RuggedizedWrist/RuggedizedWrist.github.io/media/posters/contact-pitch-locked.jpg

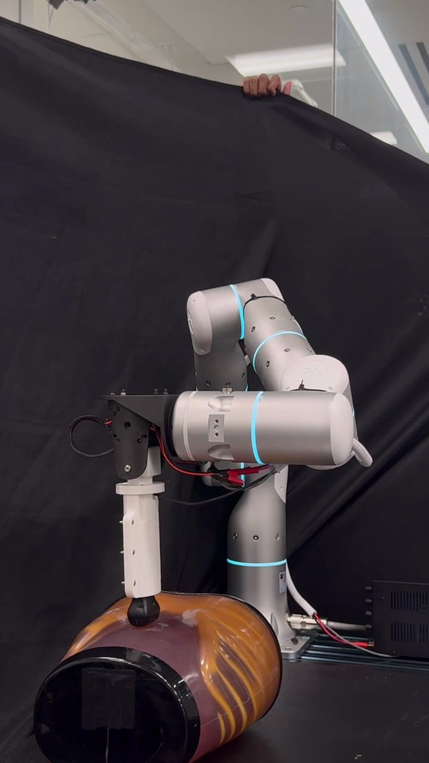
media/posters/contact-pitch-locked.jpg
