RuggedizedWrist/RuggedizedWrist.github.io/media/results/posters/cross-waist-9dof.jpg

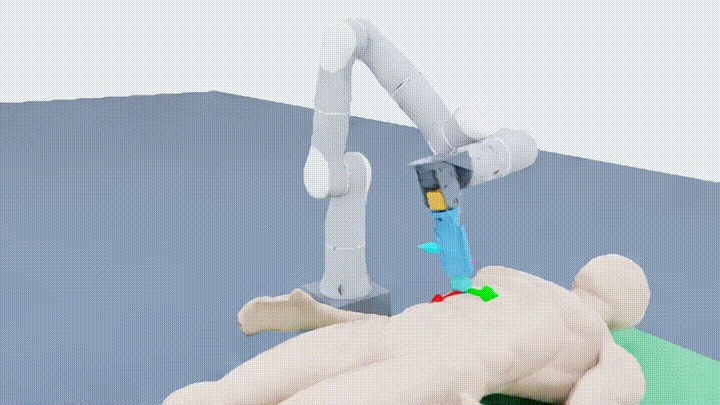
media/results/posters/cross-waist-9dof.jpg
