RuggedizedWrist/RuggedizedWrist.github.io/README.md

# DistalShift

Project page for **DistalShift: How Distal Redundancy Shapes Robot Arm Motion and Joint Loading**.

GitHub Pages serves this repository from `main` at [ruggedizedwrist.github.io](https://ruggedizedwrist.github.io/). The project is called DistalShift on the page. The organization and repository names stay RuggedizedWrist.

The anonymous review artifact is a separate repository and is not updated from here.
