RuggedizedWrist/RuggedizedWrist.github.io/docs/evidence/CLAIM_EVIDENCE_MATRIX.md

# Claim–evidence matrix

| Claim | Status | Evidence | Limitation |
|---|---|---|---|
| Higher sampled low-motion CARE coverage | supported within sampled criteria | [source](../generated/j9_corrected_all_tasks_20260907_0808/care/horizontal_v2/care_benchmark_summary.json) | method-specific arrival; geometric proxy; no global optimality |
| 97.76-97.98 percent lower proximal dynamic torque | supported in six formal free-space runs | [source](../generated/paper_s1_s2_s3_20260907/EXPERIMENT_AUDIT.json) | one pose and one deterministic trial per condition/speed; active distal allocation |
| Lower gravity-inclusive total motor torque | NOT supported by formal S3; increases 11.33-11.71 percent | [source](../generated/paper_s1_s2_s3_20260907/S23_matched_start/S3_summary/S3_metrics.csv) | total and dynamic definitions must remain separate |
| Contact torque-mechanism decomposition validated | NOT supported; diagnostic only | [source](../generated/paper_s1_s2_s3_20260907/S2_contact_15N/analysis/analysis_summary.json) | force-balance residual 0.241278 Nm exceeds 0.02 Nm |
| All contact scans passed | NOT supported | [source](../generated/j9_corrected_all_tasks_20260907_0808/rerun_manifest.json) | Cardiac/soft attempts incomplete; orientation/force gates unmet in several complete cycles |
| Reduced electrical consumption or calibrated tissue response | NOT measured | [source](../docs/PAPER_S1_S2_S3_SUPPLEMENT_ZH.md) | mechanical work is not electricity; kh is not tissue Young modulus |
| Exact mesh swept volume or hardware safety validated | NOT established | [source](../docs/PAPER_METHODS_AND_EXPERIMENTS_J9_V6_ZH.md) | joint state is available; body-center AABB and sampled clearances are only proxies |
