RuggedizedWrist/RuggedizedWrist.github.io/media/paper/distalshift.pdf

## DistalShift: How Distal Redundancy Shapes Robot Arm Motion and Joint Loading

Tian-Ao Ren¹*, Tongyu Wang¹,2*, Shixuan Zhao¹

, Rohan Karunaratne¹

, Tao Zhang¹
, Rachel
Thomasson¹

and Mark Cutkosky¹

Abstract— Seven-degree-of-freedom manipulators provide redundancy for six-dimensional tool-pose control, yet local tool reorientation can still require substantial proximal-arm motion. We present a compact two-degree-of-freedom distal wrist that localizes tool reorientation near the endpoint. The Contact-Anchored Reorientation Envelope evaluates orientation coverage under a proximal-motion budget and supports comparisons of mounting and arrival strategies. Hardware experiments compare wrist-held and wrist-actuated configurations for ultrasound probe manipulation across five free-space and phantom-contact conditions, retaining the same installed hardware. Wrist activation reduced mean reconstructed incremental proximal swept volume by 44.5–95.8% and baseline-subtracted torque excursion by 18.9–89.4%. During axial probe rotation in phantom contact, peak and RMS measured arm-joint torque decreased by 48.4% and 29.8%, respectively. These gains were task dependent and accompanied by increased orientation-tracking error. Complementary diagnostic simulations indicate lower whole-system absolute joint mechanical work than direct probe mounting, including the wrist joints’ contribution, despite higher proximal torque RMS. Together, these findings characterize how distal participation localizes tool motion and provides task-dependent mechanical benefits.

I. INTRODUCTION
Seven-degree-of-freedom (DoF) manipulators provide redundancy for controlling six-dimensional tool poses, but endpoint capability alone does not characterize the motion required from the rest of the robot [1]. After a tool reaches its target, a local orientation adjustment can still require substantial shoulder, elbow, and forearm reconfiguration. Small tool reorientations producing large swept arm motions pose an acute risk for robots operating in medical environments, where robots perform tasks beside a patient, operator, or surrounding equipment. For such robots, an important design question is not only whether the tool can reach a pose, but how much proximal motion is needed to realize it. Placing additional articulation near the tool offers a way to increase efficiency of motion. Macro–mini manipulation established the advantage of pairing a small distal mechanism

This work has been submitted to the IEEE for possible publication. Copyright may be transferred without notice, after which this version may no longer be accessible.
1Tian-Ao Ren, Tongyu Wang, Shixuan Zhao, Rohan Karunaratne, Tao Zhang, Rachel Thomasson and Mark Cutkosky are with the De-

Tongyu Wang is with the Department of Modern Mechanics, University of Science and Technology of China, Hefei, China. tongyuw@mail.ustc.edu.cn

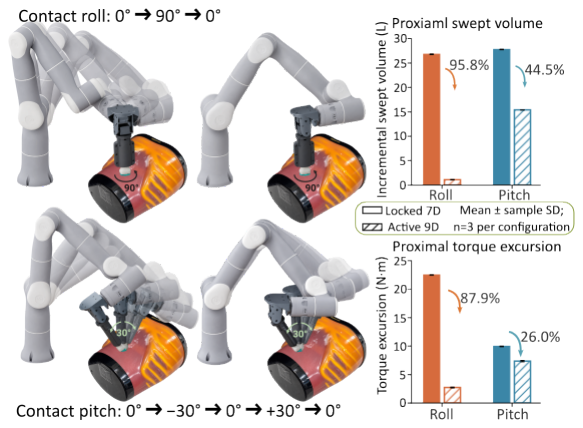
[picture p3: figure]

Fig. 1. Contact probe reorientation with a locked (7-DoF) or active (9-DoF) distal wrist. Left: simulation illustrations. Right: incremental proximal swept volume reconstructed from hardware trajectories and baseline-subtracted torque excursion (mean ± sample SD, n = 3 per condition).

with a larger positioning arm, including benefits in effective inertia and dynamic performance [2], [3]. A review of prosthetic and robotic wrists identifies compact packaging, low distal mass, and useful orientation range as recurring design considerations [4]. Recent work on compact independentwrist architectures also emphasizes a complementary tradeoff: serial wrists offer direct output joints and relatively simple kinematics, whereas parallel wrists can reduce moving mass at the cost of more involved kinematics and singularity analysis [5]. This distinction motivates treating wrist architecture and joint placement as design variables rather than counting added DoF alone. Prior work investigating the benefit of single-axis and 2-axis wrists for efficient operation in constrained spaces [6], [7] motivate studying not only the number of added joints, but their placement and use. Building on this foundation, we examine how equipping a commercial arm with a 2-DoF wrist changes both the spatial motion and measured joint loading during tool reorientation. Robot-assisted ultrasound provides a representative setting for this question. Once the probe reaches an acoustic window, it must be tilted and rotated to refine a view or change imaging planes while maintaining acoustic contact. Measurements of sonographer motion have informed end-effector designs for local probe adjustment [8]. Larger orientation changes also occur: the transthoracic echocardiography guideline describes a 90◦
transducer rotation from the parasternal longaxis view to obtain a parasternal short axis view [9]. These maneuvers motivate evaluating small local tilts and larger axial rotations near a nominal contact location, rather than treating probe positioning as a sequence of unconstrained

Hardware designs and software are available at https://ruggedizedwrist.github.io/.

[tianao, tongyuu]@stanford.edu

reaches.
Robotic ultrasound systems have been developed for diagnostic and interventional tasks across multiple clinical settings [10]. Recent work has addressed complementary aspects of this interaction, including standardized acquisition with dual-probe systems [11], automatic surface-normal alignment [12], and end-effectors that provide adjustable constant contact forces [13]. Operational-space and hybrid position–force control offer established foundations for specifying tool-motion and contact objectives [14], [15]. Our focus is the whole arm cost of realizing those objectives: the proximal configuration changes, additional occupied space, and joint loads associated with a prescribed probe motion. Evaluating these quantities alongside pose and force tracking connects endpoint performance to the robot’s behavior in its surrounding workspace.
A smaller proximal motion envelope does not by itself establish lower measured arm loading. The arm still supports the installed wrist and tool, while configuration and contactload transmission change during reorientation. We therefore examine when distal participation provides concurrent spatial and load benefits, and how these benefits relate to achieved task tracking.
We present DISTALSHIFT, an open-source 2-DoF wrist that provides local tilt and axial rotation between a commercial 7-DoF arm and its tool. A kinematic coordination layer combines wrist reorientation with the arm’s Cartesian motion–force controller and compensates for tool translation induced by wrist motion. Hardware trials compare wrist-held and wrist-actuated operation within the same installed assembly, evaluating proximal spatial sweep, measured joint loading, and achieved task tracking. The Contact-Anchored Reorientation Envelope (CARE) and configuration-envelope analyses complement these trials by characterizing mounting and arrival choices under a proximal-motion budget. A supplementary diagnostic simulation comparison adds direct probe mounting and evaluates whole-system absolute joint mechanical work across direct-probe, wrist-held, and wrist-actuated configurations, including the contribution of the distal joints.
Across five hardware task conditions, wrist activation reduced mean reconstructed incremental proximal swept volume by 44.5–95.8% and baseline-subtracted torque excursion by 18.9–89.4%. Contact roll additionally reduced peak measured proximal-joint torque by 48.4% and raw joint-andtime torque RMS by 29.8%. These results identify substantial spatial benefits and task-dependent load reductions, together with their tracking tradeoffs. Figure 1 highlights the contact-roll and contact-pitch comparisons.
The contributions are:
- An open-source 2-DoF distal wrist and an arm–wrist coordination architecture compatible with a commercial Cartesian motion–force controller.
- A contact-anchored kinematic evaluation of reorientation coverage under bounded proximal motion, including arrival-strategy and mounting comparisons.
- A hardware characterization of task-resolved proximal

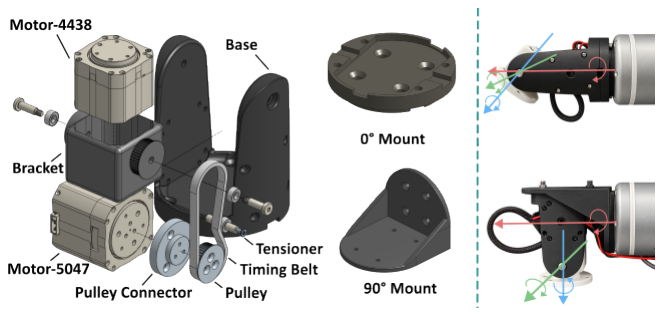
[picture p4: figure]

Fig. 2. 2-DoF distal wrist and mounting configurations. Left: exploded assembly with actuators and timing-belt transmission. Center: 0

- and 90◦
mounting adapters. Right: corresponding assembled configurations.

spatial sweep, measured joint loading, and tracking under five conditions, complemented by a diagnostic comparison of direct-mount simulation of absolute joint mechanical work of the whole-system.
Although ultrasound motivates the evaluation, the formulation concerns tool reorientation near a fixed point or contact region and can guide similar studies in inspection and surface-interaction tasks.

II. SYSTEM AND CONTROL ARCHITECTURE

A. Open-Source 2-DoF Distal Wrist

The add-on wrist introduces two actuated rotational joints between the robot flange and tool without modifying the proximal manipulator. J8 provides local tilt, and J9 provides axial rotation aligned with the ultrasound probe’s acoustic axis. This distal arrangement places orientation motion near the tool [4], [16], while the arm supplies the remaining motion.
The mechanism comprises a mounting base, a pitch stage carrying the axial-rotation assembly, and a probe adapter (Fig. 2). J8 and J9 use HighTorque HTDW-5047-36-NE and HTDW-4438-32-NE planetary actuators with 36:1 and 32:1 gear ratios, respectively, and integrated encoders. The base and mounts are printed in Markforged Onyx; the bracket, pulley, and pulley connector use Formlabs Rigid 4000 Resin. The CAD assembly and URDF specify the mechanical layout and joint transforms.
The module weighs 720 g excluding the probe, with usable ranges of ±90◦

at J8 and ±180◦
at J9. The shortened probe adapter gives a nominal flange-to-contact-point distance of 290.4 mm. Interchangeable 0

◦

and transverse 90◦ mounts
are provided; all hardware experiments used the 90◦ assembly. Local wrist joint control operated at 500 Hz, while coordinated host references and experiment logging ran at approximately 100 Hz.
B. Arm–Wrist Kinematics and Coordination

Let qa = [q1, . . . , q7]

T and qw = [q8, q9]

T denote arm and
wrist configurations. Frames W, F, C, and P denote the world, robot flange, configured fixed arm TCP, and probe frame at the nominal contact point, respectively. With ATB expressing frame B in frame A, the probe pose is

W TP (qa, qw) = W TF (qa)

F TP (qw). | (1)

The rotation Rw(qw) and translation rw(qw) of F TP (qw) follow the configured serial wrist geometry, including jointorigin and probe offsets. The commercial arm interface uses a fixed configured TCP, F TC , whereas wrist articulation changes the actual flange-to-probe transform. Scripted pitch θ and axial roll ϕ specify W RP,d = W RP,0Rx(θ)Rz(ϕ), where W RP,0 is the initial probe orientation.
A kinematic coordination layer couples wrist actuation with the Flexiv non-real-time Cartesian motion–force interface, following the operational-space and hybrid position– force framework [14], [15]. For active operation, a bounded iterative orientation allocator produces q

alloc
w . Filtering, velocity and acceleration limits, joint margins, and a trackinglead bound yield q

cmd
w ; successive commands determine wrist velocity references. The residual flange orientation and translation compensation are

W RF,d =

W RP,dRw(q

alloc
w )

T
, | (2)

W pF,d =

W pP,d −

W RF,mrw(q

meas
w | ), | (3)

where d and m indicate desired and measured quantities. Coordination therefore combines residual orientation assignment with offset compensation, using the allocated wrist configuration for orientation and measured wrist angles and flange orientation for translation. In locked operation, the wrist holds its starting angles with powered drives, and the flange target is W TF,d = W TP,d[

F TP (q

meas

w )]⁻¹
. Both conditions use the fixed-TCP command W TC,d = W TF,d

F TC .
In free space, the arm uses Cartesian impedance control and the wrist tracks position–velocity references. During contact, the arm regulates force along the z-axis of a worldfixed task frame aligned with the initial probe push direction n, while tangential translation and orientation remain motion controlled. The normal-position reference follows the measured probe position, allowing force regulation to adjust contact depth. Wrist tracking is supplemented by bounded rotational impedance assistance, gravity compensation, and contact-force feedforward. Orientation error and measured wrist angular velocity generate an impedance moment mapped to J8–J9 through the wrist Jacobian transpose. The host supervises contact engagement; continuous force regulation remains within the Flexiv controller and does not use the host force estimate as a replacement feedback signal.
C. Calibration and Measurement
Probe geometry uses tuned joint origins, axes, encoder offsets, and the probe-tip transform, with encoder zeros synchronized to the mechanical reference posture. The fixed Flexiv tool definition retains a nominal payload mass of 1.204 kg, distinct from the wrist-module mass. Host force observation subtracts an empirical unloaded-force model, affine in flange-frame gravity, and a session offset captured once before contact. The corrected force is rotated to the world frame and supplemented by a bounded nominal-payloadmass times acceleration term to obtain fˆ︁W ; acceleration is estimated from fixed-payload center-of-mass velocity and filtered. Positive compression is fc = −n

Tfˆ︁W . Forceerror evaluation uses this estimate before the final scalar low-pass filter applied for contact supervision. The session offset remains fixed during contact; configurations outside the calibration domain use model extrapolation. Arm torque comes from the robot’s joint-torque channels. Probe pose and force metrics use kinematic reconstruction and processed flange sensing rather than independent external metrology.

III. TASK-DRIVEN KINEMATIC AND DYNAMIC ANALYSIS

A. Compared Simulation Strategies

The supplementary contact simulations compare direct-probe, wrist-held, and wrist-actuated configurations under shared probe-level references, timing, and contact conditions. Each configuration retains its respective mounting geometry and modeled distal mass. Whole-system absolute joint mechanical work is evaluated in Section III-F.
The offline kinematic study compares four allocation strategies: locked 7-DoF arm-only IK; generic 9-DoF IK with near-equal joint costs; distal-weighted 9-DoF IK that penalizes J1–J7 more than J8–J9; and a reorientation-aware method that selects the contact-arrival posture before using distal-weighted IK. The weighting is a null-space design choice, not a second controller or an equal-cost assumption [17].
The distal-weighted strategy uses
WD = diag(25I7, I2). | (4)

Here, I7 and I2 correspond to the proximal arm and distal wrist. The 25:1 ratio favors J8 and J9 while allowing J1–J7 to move when required by pose feasibility, joint limits, or clearance.

B. Reorientation-aware arrival selection

At each contact, equal-weight nine-joint IK solves the same zero-tilt, zero-axial-rotation probe pose from seven deterministic seeds: the configured Home and six singlejoint perturbations (J1: ±0.28 rad; J3: ±0.30 rad; J7: ±0.45 rad). Converged solutions are deduplicated at a nine-joint Euclidean distance below 10⁻³
rad. Each candidate
independently initializes distal-weighted IK for 15 coarse targets formed by tilt {−25, 0, 25}

◦
and axial rotation
{−90, −45, 0, 45, 90}

◦
, a subset of the full grid. Coarse success requires pose convergence within 2 mm and 2

◦
| , at
most 8

◦
J1–J7 RMS displacement from the candidate, and nonnegative target clearance. Candidates are ranked lexicographically by higher coarse success fraction, greater arrival clearance, and lower mean proximal RMS displacement over successful coarse targets; exact ties retain the first candidate. Arrival clearance is a ranking criterion, not a hard candidate filter. If all seven seeds fail, a Home-seeded fallback records arrival failure, and all full-grid targets remain infeasible. The selected arrival independently initializes all 143 targets using the unchanged target-level IK of the distal-weighted baseline, without inter-target warm starts or full-grid-based reselection.

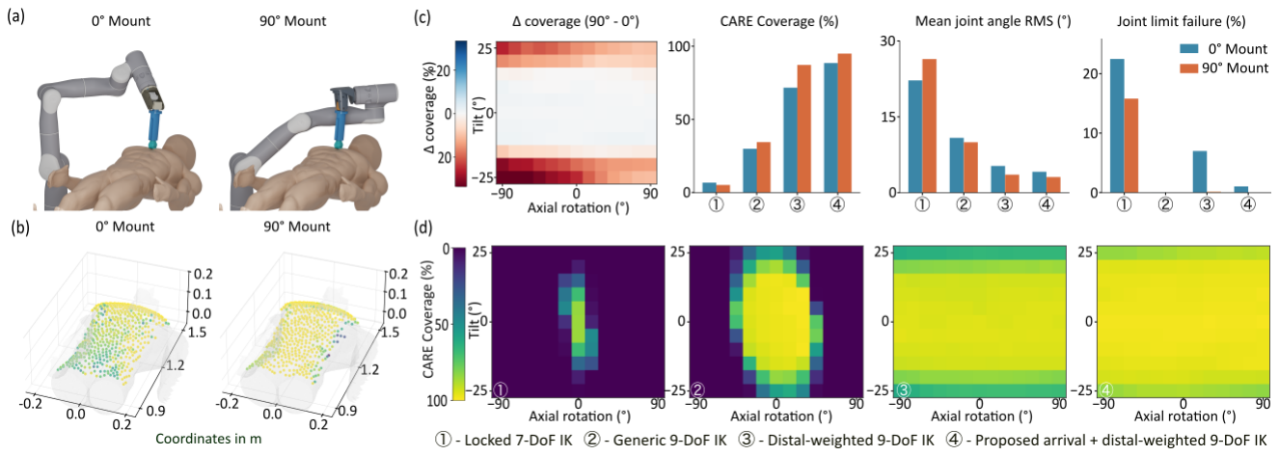
[picture p5: figure]

Fig. 3. CARE comparison of the original 0 ◦ and transverse 90◦ mounts. (a) Matched Isaac Sim renderings. (b) The 525 sampled torso contacts colored by proposed-method coverage over 143 tilt–axial- rotation targets. (c) Proposed-method coverage difference (90◦ − 0

◦), aggregate coverage, mean proximal J1–J7 RMS displacement, and joint-limit failure rate for the four methods. (d) Orientation-resolved coverage for the 90◦ mount. Heatmaps use a common 0–100% scale; positive difference means higher 90◦ coverage. Archived Home seeds and hardware revisions differ, so this is a complete-assembly comparison, not an isolated causal mount-angle ablation.

C. Clinically Motivated Reorientation Tasks
1) Local Ultrasound View Adjustment: The local-view task keeps the probe at the nominal parasternal contact region while commanding 0
- → +5◦ → −5
- → 0

◦
tilt at constant
normal force in clinical [10], [8]. The ±5
- motion represents
fine view correction; optional ±15◦

and ±30◦
trials stress the
extended range of a robotic ultrasound end effector. Both systems receive identical references.
2) Imaging-Plane Switching: The imaging-plane task rotates the probe about its acoustic axis as 0
- → 90◦ →
0

◦
at the same contact point and normal-force command. This PLAX-to-PSAX-style transition follows the guideline description of an approximately 90◦
clockwise rotation while
maintaining the parasternal window [9]; the return tests reversibility.
D. Reorientation Coverage Under a Proximal-Motion Budget (CARE)

The Contact-Anchored Reorientation Envelope (CARE) is the sampled set of probe orientations feasible at a fixed torso contact point under pose tolerances, joint limits, a geometric-clearance condition, and a J1–J7 motion budget. It is an offline capability-style kinematic benchmark [18], [19]; it does not measure force tracking, dynamic torque, tissue deformation, or continuous trajectory feasibility.
We sample Nc = 525 torso contact locations from the original patient mesh. At contact i, the neutral orientation is Ri,0, the acoustic-face center is pi
, and the target for local tilt αg and axial rotation βg is

R

d

i,g = Ri,0Ry(αg)Rz(βg), pd
i,g = pi
. | (5)

Here, Ry(αg) applies local tilt and Rz(βg) axial rotation about the tilted probe axis; p

d
i,g = pi keeps the acoustic-face center at the original contact point. Tilt angles span −25◦

to +25◦
in 5

◦
increments and
axial angles span −90◦

to +90◦

in 15◦
increments, giving
Ng = 143 targets per contact. The damped weighted IK solver uses coefficient 0.008, at most 90 iterations, maximum joint increment 0.20 rad, and a 1

◦
joint-limit margin.
For a fixed method m, contact i, and target g, let ∆qa,j denote the change of proximal joint j between the neutral arrival configuration and the target IK solution.The RMS proximal joint displacement is

da =

180
π

⌜⃓⃓⎷
1
7

∑︂

7

j=1

(∆qa,j )

2 [deg]. | (6)

This is the post-arrival RMS change of J1–J7 in degrees. J8 and J9 remain in the IK and joint-limit checks but are excluded from da, which measures only proximal-arm motion.
Let PF⁽m)
i,g denote the pose-feasibility indicator. It equals one only when the IK solution satisfies the translational tolerance of 2 mm, the rotational tolerance of 2

◦
, and the 1

◦
joint-limit margin; otherwise, it equals zero. For a proximal-motion budget B, the CARE success indicator is

I

(m)

i,g (B) = PF⁽m)
i,g 1{da ≤ B}1{cproxy ≥ 0}. (7)

Here, 1{·} is an indicator. The terms enforce pose feasibility, the J1–J7 RMS budget B, and nonnegative sampled clearance cproxy. The proxy compares link-centerline envelopes with the torso height field and bed bounding box; it rejects sampled penetration but is not continuous mesh collision checking or a hardware-safety certificate.
CARE coverage is calculated over all sampled contacts and orientation targets, including failed targets in the denominator:

CARE⁽m)

(B) = 1
NcNg

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
i,g (B). (8)

Thus, CARE⁽m)
(B) is the fraction of all 525 × 143 = 75,075 targets satisfying pose feasibility, the proximal-motion budget, and sampled clearance. The primary analysis

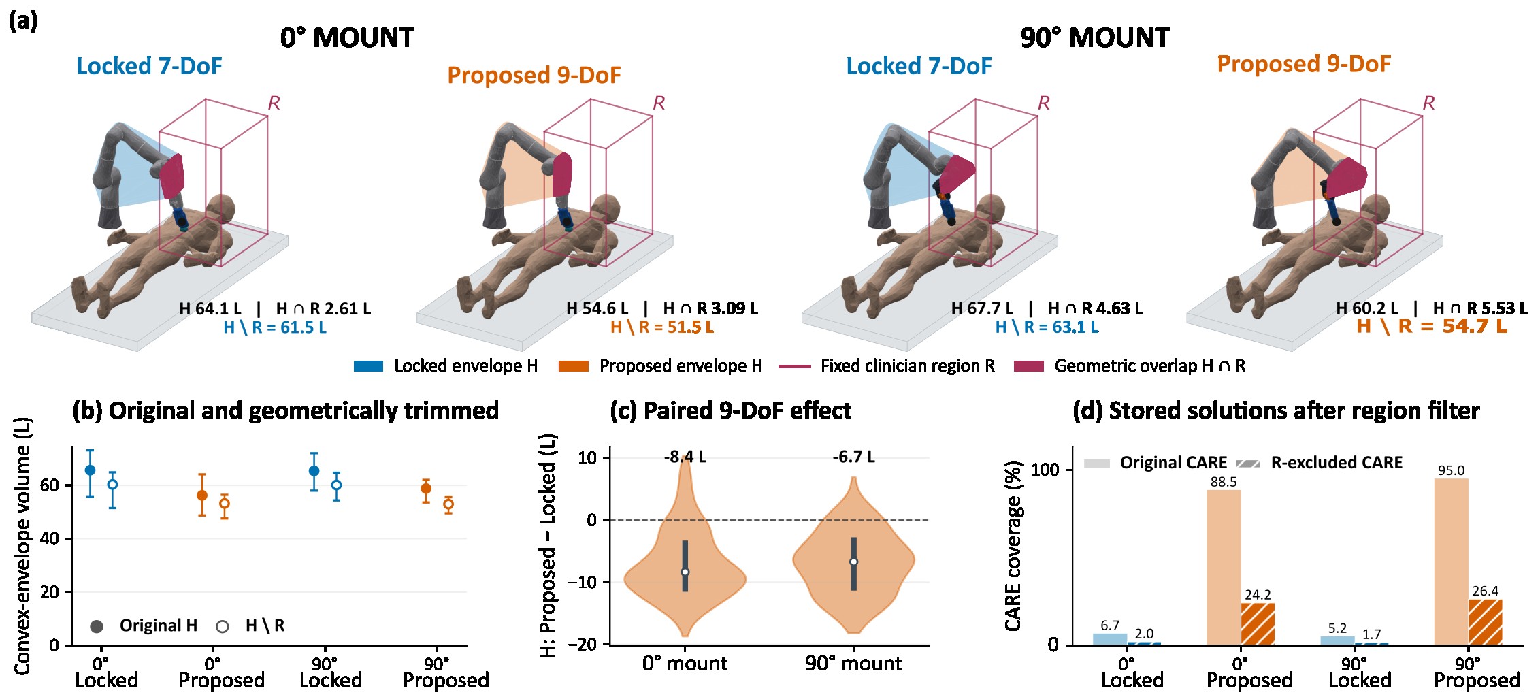
[picture p6: figure]

Fig. 4. CARE-based configuration envelopes and clinician-side screening for the 0

- and 90◦ assemblies. (a) Proximal hulls H at a common representative contact, fixed nominal region R, and their geometric intersections. (b) H and H \ R volumes; the latter is geometric trimming, not replanned motion. (c) Paired proposed-minus-locked hull-volume differences (median/IQR over 407 contacts with four-way shared targets). (d) Original and stored-target regionscreened coverage, each using all 75,075 targets per condition. Envelopes include method-specific neutral arrivals; the main coverage screen evaluates stored target configurations.

uses B = 8◦
and compares locked 7-DoF, generic 9-DoF, distal-weighted 9-DoF, and reorientation-aware arrival strategies.
Because methods may use different neutral arrival postures, CARE compares complete system-and-arrival policies rather than a matched-start causal ablation.
Mounting and allocation results: For the 0

◦
assembly,
CARE coverage was 6.74%, 29.90%, 71.67%, and 88.50% for arm-only, generic 9-DoF, distal-weighted, and proposed arrival-aware strategies, respectively. For the 90◦ assembly,
the corresponding values were 5.15%, 34.45%, 87.21%, and 94.96%. The intermediate nine-DoF comparisons show that coverage under the prescribed proximal-motion budget depends on allocation and arrival selection, rather than joint count alone. Within the evaluated mounting-and-arrival configurations, proposed-method coverage was 6.46 percentage points higher for the 90◦
assembly, providing a coverageoriented mounting rationale.
E. Kinematic Envelopes and Clinician-Side Workspace For each contact, we retain orientation targets successful in all four mounting–strategy conditions (0

◦

/90◦
and
locked/proposed). The hull H contains the transformed J1– J7 collision-mesh vertices at these stored solutions and each condition’s neutral arrival. This is a sampled configuration envelope, without trajectory interpolation. The numerical model retains the CARE pipeline’s J7 placement correction. Statistics include all 407 contacts with nonempty four-way intersections; empty sets are excluded rather than assigned zero volume. The representative contact in Fig. 4(a) is the centroid-nearest contact among those with at least five shared targets.
The fixed nominal clinician-side region is a box centered at (0.80, 0.06, 0.50) m with dimensions 0.50×0.60×0.90 m, aligned with the common robot-base frame. Positive y points

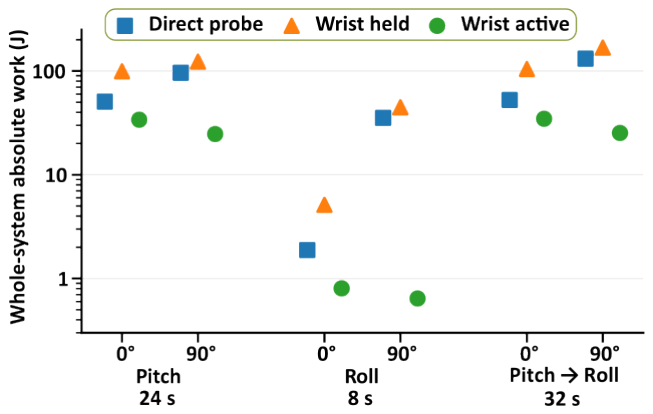
[picture p7: figure]

Fig. 5. Whole-system absolute joint mechanical work in 15 N contact simulations: pitch (0

| ◦ →+30◦ →−30◦ →0 ◦, 24 s), roll (0 ◦ →90◦, 8 s),
and their continuous sequence (32 s). The 0
| ◦ and 90◦ groups retain distinct
direct-probe baselines. Bars represent single runs; active totals include J8– J9. Results remain diagnostic: dynamics checks are unmet, with additional tracking violations in pitch and combined runs.

headward and positive x toward the clinician side. All methods and mountings use this same headward, robotnear layout. We report the geometric overlap H ∩ R and remainder H \ R. Separately, the stored-target screen rejects original CARE successes whose proximal mesh vertices enter R, without re-solving IK. Its denominator remains all 75,075 sampled targets; neutral-arrival intersections are logged separately and do not enter the main screen. This is a vertex-based layout screen rather than continuous collision checking.
On shared targets, the proposed strategy reduced hull volume relative to the locked baseline by a median paired 8.36 L (12.7%) at 0
| ◦

and 6.71 L (10.3%) at 90◦
. Under
the revised region screen, proposed coverage was 24.17% and 26.36%, compared with 2.03% and 1.65% for the corresponding locked baselines. Thus the proposed strategy combines smaller shared-target proximal envelopes with a larger set of accepted stored targets. The proposed 90◦ assembly retained 2.19 percentage points more coverage than its 0
| ◦
counterpart, although its paired hull volume was 1.38 L larger at the median. Mounting selection therefore

TABLE I

SPATIAL AND MEASURED-LOAD STATISTICS (MEAN ± SAMPLE SD, n = 3 PER ROW). V∆ IS RECONSTRUCTED OVER THE EXECUTED INTERVAL; Pτ ,

Rτ , AND Eτ USE MOTION SAMPLES ONLY.

Task | Wrist | V∆ (L) | Pτ (N m) | Rτ (N m) | Eτ (N m)
Free axial | Locked | 27.28 ± 0.03 | 53.10 ± 0.07 | 18.932 ± 0.005 | 23.226 ± 0.027
| Active | 1.25 ± 0.01 | 30.24 ± 0.08 | 14.322 ± 0.015 | 2.454 ± 0.052
Free square | Locked | 70.84 ± 0.04 | 65.89 ± 0.10 | 19.426 ± 0.009 | 21.816 ± 0.080
| Active | 30.03 ± 0.09 | 56.22 ± 0.04 | 19.159 ± 0.022 | 11.691 ± 0.145
Contact roll | Locked | 26.80 ± 0.05 | 48.94 ± 0.99 | 16.362 ± 0.012 | 22.491 ± 0.044
| Active | 1.13 ± 0.01 | 25.27 ± 0.09 | 11.484 ± 0.007 | 2.729 ± 0.057
Contact pitch ±15◦ | Locked | 14.19 ± 0.02 | 57.63 ± 0.43 | 21.513 ± 0.007 | 5.490 ± 0.210
| Active | 7.85 ± 0.01 | 55.54 ± 0.19 | 21.490 ± 0.011 | 4.450 ± 0.024
Contact pitch ±30◦ | Locked | 27.78 ± 0.04 | 60.88 ± 0.66 | 21.651 ± 0.006 | 9.948 ± 0.039
| Active† | 15.41 ± 0.01 | 58.90 ± 0.31 | 21.781 ± 0.007 | 7.364 ± 0.108

balances reorientation coverage and spatial footprint rather than treating their benefits as interchangeable.

F. Whole-System Mechanical Work

To complement the same-assembly hardware comparison, we analyze 18 contact simulations spanning two mounting geometries and direct-probe, wrist-held, and wrist-actuated configurations, with shared nominal probe references and timing within each task. Modeled distal masses are 0.484 kg for direct mounting and 1.204 kg with the wrist. Whole-system absolute joint mechanical work is

Wabs =

∫︂

T

∑︂

j∈J

|τm,j (t) ˙qj (t)| dt, | (9)

using full gravity-inclusive simulated drive torque and actual joint velocity, without baseline subtraction. The sum includes J1–J7 for direct/held and J1–J9 for actuated operation. Across the six task–mount pairs, recorded Wabs was 33.1– 98.2% lower in actuated operation than with the corresponding direct mounts (Fig. 5). The 90◦
actuated assembly also
had lower absolute work than both evaluated direct mounts in every task. Proximal raw torque RMS was nevertheless 5.0–39.6% higher than the corresponding direct mounts. These diagnostic observations suggest reduced whole-system mechanical-work throughput, including the wrist’s contribution, rather than lower electrical consumption or uniformly lower joint loading.

IV. HARDWARE EXPERIMENTS AND RESULTS

Hardware experiments quantified proximal-arm spatial sweep and joint loading during scripted probe motion; pose tracking, processed force error, and execution pauses provide the associated task-fidelity context.

A. Experimental Protocol and Evaluation Metrics
a) Setup and comparisons: The setup comprised a Flexiv Rizon 4s arm, the 2-DoF wrist, a Butterfly iQ+ probe [20], and an ABDFAN ultrasound-training phantom [21]. The contact protocol follows prior force-regulated robotic-ultrasound end-effectors [13], [22]. Both configurations used the same 90◦
assembly, payload, scripted references, timing, and task-specific controllers (Section II-B). Initial states were nominally matched and recorded, with each trial’s initial arm configuration supplying the null-space reference. Locked J8–J9 used powered position holding with zero reference velocity. This same-assembly comparison evaluates the benefit of using the installed distal articulation together with its coordination policy. Arm translational stiffness was 3500 N/m per axis. Rotational stiffness and damping ratios were 675 N m/rad and 0.7 in free space, and 300 N m/rad and 0.8 in contact, where the normal direction was force controlled. Each of the five conditions in Table II comprised three trials per configuration (30 trials total). Conditions were analyzed separately, retaining records with tracking penalties or internal pauses.

TABLE II

SCRIPTED TASK CONDITIONS. EACH HAS THREE LOCKED AND THREE

ACTIVE TRIALS. DURATIONS ARE NOMINAL MOTION TIMES,

EXCLUDING APPROACH AND PRE-/POST-HOLDS.

Task | Probe reference | Time (s) Force (N)
F-axial | 0
- → 90◦ → 0
◦; 5 s hold at 90◦ | 16 | –
F-square | 100 mm square; midpoint pitch
±30◦; corner roll ±45◦
416 | –
C-roll | 0
- → 90◦ → 0
- | 32 | 15
C-pitch | 0
- → −α → 0
- → +α → 0

◦;
α = 15◦ or 30◦
32 | 15

F and C denote free-space and contact tasks. The two pitch amplitudes are distinct conditions. Active 30◦ contact pitch additionally incurred internal pauses, reported in the results.

b) Intervals and measured torque: The motion interval M contains samples labeled motion *; preparation, approach, settling, holds, and pauses are excluded. For scalar xk, timestamp-weighted RMS is

RM(x) = √︄∑︁
k∈M ∆tkx

2
∑︁

k
k∈M ∆tk
, | (10)

where ∆tk is the next timestamp difference and the last sample has zero weight. With τi
the measured proximal
torque and τ¯i,0 its mean during the nominal 5 s initial hold,

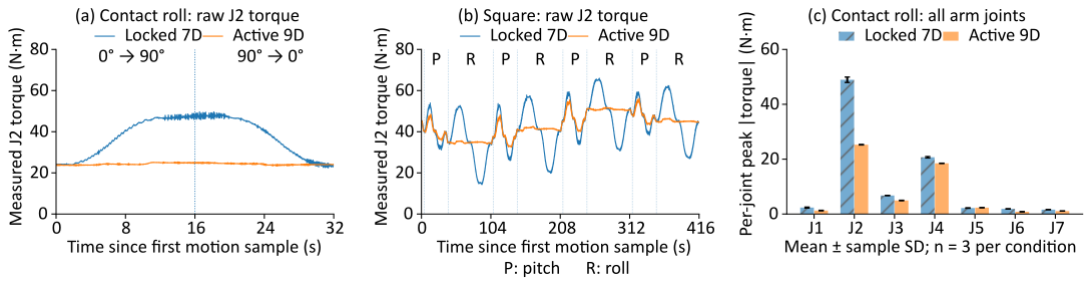
[picture p8: figure]

Fig. 6. Measured proximal torque. (a) Raw J2 contact-roll and (b) square traces for repeat 1 over the complete motion interval; no smoothing, warping, or fitted shifts. P/R mark pitch/roll and intervening segments are translations. (c) Per-joint contact-roll peak torque (mean ± sample SD, n = 3). J2 was the maximum-load joint and is not representative of all seven joints.

we report

Pτ = max
i=1,...,7
k∈M
|τi,k|, | (11)

Rτ =

⌜⃓⃓⎷
1
7

∑︂

7

i=1

RM(τi)

2, | (12)

Eτ =

∑︂

7

i=1

RM(τi − τ¯i,0). | (13)

Pτ and Rτ summarize peak and raw RMS loading. The overview’s complementary Eτ sums seven per-joint RMS values; it is not a resultant torque. Initial-hold subtraction does not remove changing gravity, contact, or friction loads, and none of these statistics is energy or an isolated inertial/velocity-product torque.
c) Reconstructed spatial sweep: Recorded J1–J7 trajectories drove the archived arm URDF and seven closed collision meshes. Let O(t) be their occupied-solid union and O0 the first-motion occupancy. Over the executed interval Te (holds and pauses retained), we compute

U = O0 ∪

⋃︂

t∈Te

O(t), | (14)
V∆ = vol(U \ O0). | (15)

V∆ excludes the initial region and counts overlaps and revisits once. The base, wrist, probe, cables, and phantom are excluded; this is a collision-model reconstruction, not direct volume metrology or a whole-system safety metric. All trials used a world-aligned 2.5 mm voxel grid and a 0.625 mm sampled-vertex displacement threshold with interval boundaries preserved. Halving that threshold changed ten representative repeat-1 results by at most 1.36%; the four axial cases checked at 1.25 mm changed by at most 0.90%. These are sensitivity checks, not geometric error bounds.
d) Aggregation and task fidelity: Each trial contributes one value. Figures and load statistics report mean ± sample SD, with reductions from condition means; SD is withinsetting scatter, not model uncertainty. CSV recomputation agreed with archived torque metrics. Table I summarizes spatial/load results; Table III retains motion-window pose/force RMSE and pauses internal to Te. Probe pose is arm–wrist FK and force is a processed flange-sensor estimate, not independent metrology.
B. Free-Space Reorientation and Composite Motion
a) Axial reorientation: The free-space axial task showed concurrent spatial and load benefits: wrist activation reduced incremental proximal swept volume by 95.4% and peak measured arm torque by 43.1%. Raw RMS torque also decreased, although active orientation-tracking error was larger.
b) Composite square task: Phase-resolved results show that reduced proximal motion was concentrated in reorientation. Summed J1–J7 travel was nearly unchanged during translation but decreased during pitch and especially roll, where it fell from 50.320 to 1.061 rad. The largest measured torque occurred during roll in locked operation and during pitch in active operation (Fig. 6(b)). Despite the smaller spatial sweep and torque excursion, motion-window raw RMS torque decreased by only 1.4%.
C. Phantom-Contact Reorientation

Contact tasks used a 15 N processed-compression setpoint, with contact depth governed by normal-force regulation during reorientation.
a) Axial contact reorientation: Contact roll combined a 95.8% reduction in incremental proximal swept volume with 48.4% lower peak measured arm torque and 29.8% lower raw joint-and-time torque RMS. J2 was the maximum-load joint (Fig. 6(a,c)). Processed normal-force RMSE was 0.176 N for locked and 0.126 N for active operation; active orientation and tangential tracking errors were larger (Table III).
b) Contact pitch at two amplitudes: Both pitch amplitudes retained spatial and torque-excursion benefits. Incremental swept volume decreased by approximately 45%, while excursion decreased by 18.9% at 15◦

and 26.0% at 30◦
Raw RMS torque was nearly unchanged at 15◦ and increased
by 0.60% at 30◦

. The active 30◦
trials included 2.43±0.03 s of internal pauses and had larger processed force error (Table III). Pauses were retained in spatial reconstruction but excluded from the primary motion-only torque statistics; excursion remained lower when pauses were included. These same-setting repetitions do not establish crossworkspace generalization, whole-system energy savings, or clinical imaging quality.

TABLE III

TASK-FIDELITY CONTEXT: MOTION-WINDOW MEANS OVER THREE

TRIALS. THESE ARE NOT PEAK ERRORS OR INDEPENDENTLY MEASURED

ABSOLUTE ACCURACIES; PAUSES ARE INTERNAL TO Te.

Task | Wrist | ep (mm) eR (

◦) ef (N) Pause (s)

F-axial | Locked | 0.635 | 1.469 | – | 0.00
| Active | 0.536 | 3.264 | – | 0.00
F-square | Locked | 0.542 | 0.341 | – | 0.00
| Active | 1.259 | 1.423 | – | 0.00
C-roll | Locked | 0.354 | 0.657 | 0.176 | 0.00
| Active | 0.611 | 1.614 | 0.126 | 0.00
C-pitch 15◦ Locked | 0.432 | 0.261 | 0.209 | 0.00
| Active | 1.108 | 0.729 | 0.206 | 0.00
C-pitch 30◦ Locked | 0.614 | 0.476 | 0.605 | 0.00
| Active† | 1.596 | 1.182 | 1.059 | 2.43

ep: FK position RMSE in free space or tangential RMSE in contact; eR: FK orientation RMSE; ef : processed normal-force RMSE. The † condition contains internal pauses. Force estimation can extrapolate outside its calibration domain; small internal RMSE is not independent force-accuracy validation.

V. DISCUSSION
The CARE comparisons show that distal redundancy should be considered together with motion allocation and arrival selection. The proposed strategy increased sampled coverage and reduced shared-target proximal configuration envelopes relative to locked operation in both assemblies. Higher coverage for the 90◦
assembly, but not a uniformly smaller envelope, motivates evaluating mounting by both task access and proximal space.
The hardware results distinguish spatial savings from measured-load reductions. Axial reorientation provided both, whereas contact pitch retained smaller swept volumes and torque excursions with little change in raw torque RMS. A lower Eτ indicates smaller departures from the initial holding torque, not necessarily a lower raw torque magnitude. The square task reinforces this distinction: proximal travel decreased mainly during reorientation, while aggregate motion-window raw RMS changed little.
The direct-mount diagnostics further show that lower whole-system absolute joint mechanical work can coexist with higher proximal torque RMS, even when the wrist’s own work is included.
Together, these findings motivate matching distal articulation and its coordination policy to the tool’s dominant reorientation demands, rather than evaluating added DoF alone. The hardware benefits were obtained through the existing commercial motion–force interface. Increased orientation errors and the pauses in the largest pitch condition identify coordinated tracking as a priority for refinement; application suitability should be assessed against task-specific pose, force, and timing requirements.

VI. CONCLUSIONS
We presented an open-source two-DoF distal wrist integrated with a commercial seven-DoF arm. CARE and configuration-envelope analyses inform mounting and arrival choices. Across five hardware conditions, wrist activation reduced incremental proximal swept volume by 44.5–95.8% and baseline-subtracted torque excursion by 18.9–89.4%, with additional raw-torque reductions in axial reorientation. Complementary diagnostic simulations indicate lower whole-system absolute joint mechanical work than direct probe mounting, including the wrist’s own contribution, despite higher proximal torque RMS. Together, these results support task-aware mounting and coordination for localizing tool motion and obtaining task-dependent load and mechanical-work benefits, assessed alongside achieved tracking performance.

ACKNOWLEDGMENT
Acknowledgements omitted for double-blind review.

REFERENCES

[1] B. Siciliano and O. Khatib, Springer Handbook of Robotics. Springer, 2016.
[2] O. Khatib, “Reduced effective inertia in macro-/mini-manipulator systems,” in The fifth international symposium on Robotics research, 1991, pp. 279–284.
[3] A. Bowling and O. Khatib, “Design of macro/mini manipulators for optimal dynamic performance,” in Proceedings of the IEEE International Conference on Robotics and Automation, vol. 1. IEEE, 1997, pp. 449–454.
[4] N. M. Bajaj, A. J. Spiers, and A. M. Dollar, “State of the art in artificial wrists: A review of prosthetic and robotic wrist design,” IEEE Transactions on Robotics, vol. 35, no. 1, pp. 261–277, 2019.
[5] C. Devmalya, B. Kim, and O. Khatib, “Maestro: High-performance, compact, singularity-free, and intrinsically safe robot arm,” in Proceedings of the International Symposium on Experimental Robotics (ISER), 2025.
[6] W. Ruotolo, R. Thomasson, J. Herrera, A. M. Gruebele, and M. R. Cutkosky, “Distal hyperextension is handy: High range of motion in cluttered environments,” IEEE Robotics and Automation Letters, vol. 5, no. 2, pp. 921–928, 2020.
[7] R. Thomasson, A. Bernardini, H. Li, C. Xing, A. Hajj-Ahmad, and
M. R. Cutkosky, “SLIM: A symmetric, low-inertia manipulator for constrained, contact-rich spaces,” IEEE Robotics and Automation Letters, vol. 10, no. 9, pp. 8682–8689, 2025.
[8] L. Lindenroth, R. J. Housden, S. Wang, J. Back, K. S. Rhode, and
H. Liu, “Design and integration of a parallel, soft robotic end-effector for extracorporeal ultrasound,” IEEE Transactions on Biomedical Engineering, vol. 67, no. 8, pp. 2215–2229, 2020.
[9] C. Mitchell, P. S. Rahko, L. A. Blauwet, B. Canaday, J. A. Finstuen,
M. C. Foster, K. Horton, K. O. Ogunyankin, R. A. Palma, and E. J. Velazquez, “Guidelines for performing a comprehensive transthoracic echocardiographic examination in adults: Recommendations from the american society of echocardiography,” Journal of the American Society of Echocardiography, vol. 32, no. 1, pp. 1–64, 2019.
[10] A. M. Priester, S. Natarajan, and M. O. Culjat, “Robotic ultrasound systems in medicine,” IEEE Transactions on Ultrasonics, Ferroelectrics, and Frequency Control, vol. 60, no. 3, pp. 507–523, 2013.
[11] J. Housden, S. Wang, X. Bao, J. Zheng, E. Skelton, J. Matthew, Y. Noh,
O. Eltiraifi, A. Singh, D. Singh, and K. Rhode, “Towards standardized acquisition with a dual-probe ultrasound robot for fetal imaging,” IEEE Robotics and Automation Letters, vol. 6, no. 2, pp. 1059–1065, 2021.
[12] X. Ma, W.-Y. Kuo, K. Yang, A. Rahaman, and H. K. Zhang, “A-SEE: Active-sensing end-effector enabled probe self-normal-positioning for robotic ultrasound imaging applications,” IEEE Robotics and Automation Letters, vol. 7, no. 4, pp. 12 475–12 482, 2022.
[13] X. Bao, S. Wang, R. J. Housden, J. V. Hajnal, and K. S. Rhode, “A constant-force end-effector with online force adjustment for robotic ultrasonography,” IEEE Robotics and Automation Letters, vol. 6, no. 2, pp. 2547–2554, 2021.
[14] O. Khatib, “A unified approach for motion and force control of robot manipulators: The operational space formulation,” IEEE Journal on Robotics and Automation, vol. 3, no. 1, pp. 43–53, 1987.
[15] M. H. Raibert and J. J. Craig, “Hybrid position/force control of manipulators,” Journal of Dynamic Systems, Measurement, and Control, vol. 103, no. 2, pp. 126–133, 1981.
[16] K. V. Gochev, V. Narayanan, B. J. Cohen, A. Safonova, and
M. Likhachev, “Motion planning for robotic manipulators with independent wrist joints,” in 2014 IEEE International Conference on Robotics and Automation (ICRA). IEEE, 2014, pp. 461–468.

[17] A. Dietrich, C. Ott, and A. Albu-Schaffer, “An overview of null space ¨ projections for redundant, torque-controlled robots,” The International Journal of Robotics Research, vol. 34, no. 11, pp. 1385–1400, 2015.
[18] F. Zacharias, C. Borst, and G. Hirzinger, “The capability map: A kinematic representation for multicontact planning,” The International Journal of Robotics Research, vol. 30, no. 12, pp. 1555–1576, 2011.
[19] V. Kumar, S. Sen, S. S. Roy, C. Har, and S. Shome, “Design optimization of serial link redundant manipulator: an approach using global performance metric,” Procedia Technology, vol. 14, pp. 43–50, 2014.
[20] Butterfly Network, “Butterfly iQ+ ultrasound system,” https://www.butterflynetwork.com/iq-plus, 2026, accessed: Sep. 2026.
[21] Kyoto Kagaku, “ABDFAN abdominal ultrasound examination phantom,” https://www.kyotokagaku.com, 2026, accessed: Sep. 2026.
[22] X. Bao, S. Wang, L. Zheng, R. J. Housden, J. V. Hajnal, and K. Rhode, “A novel ultrasound robot with force/torque measurement and control for safe and efficient scanning,” IEEE Transactions on Instrumentation and Measurement, vol. 72, pp. 1–12, 2023.
