RuggedizedWrist/RuggedizedWrist.github.io/media/cross-waist-7dof.gif

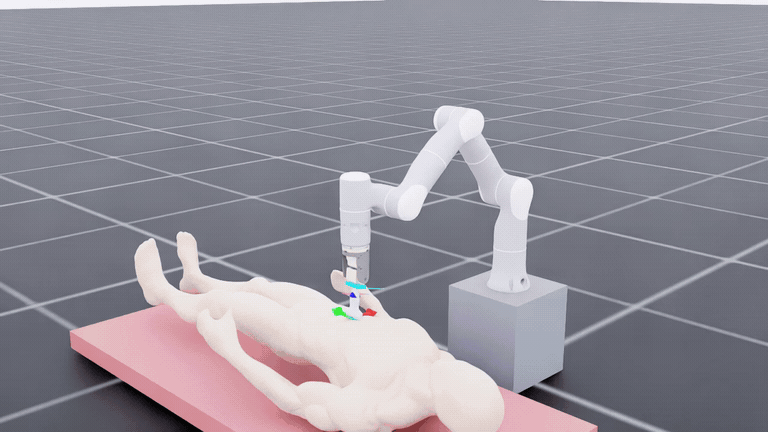
media/cross-waist-7dof.gif
