RuggedizedWrist/RuggedizedWrist.github.io/media/cross-waist-9dof.gif

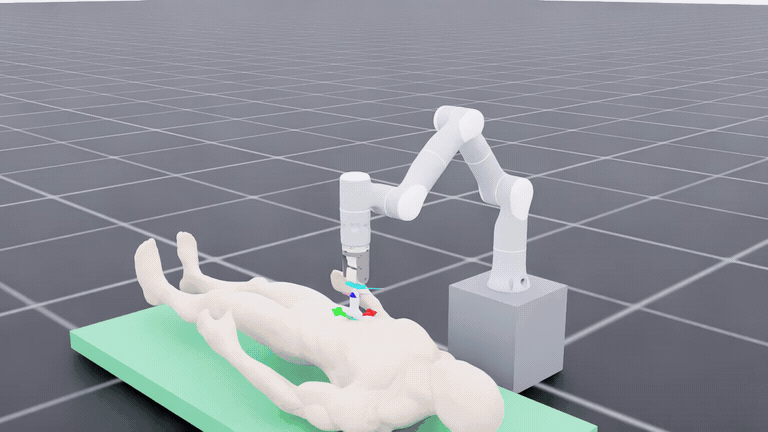
media/cross-waist-9dof.gif
