RuggedizedWrist/RuggedizedWrist.github.io/media/figures/contact-roll.png

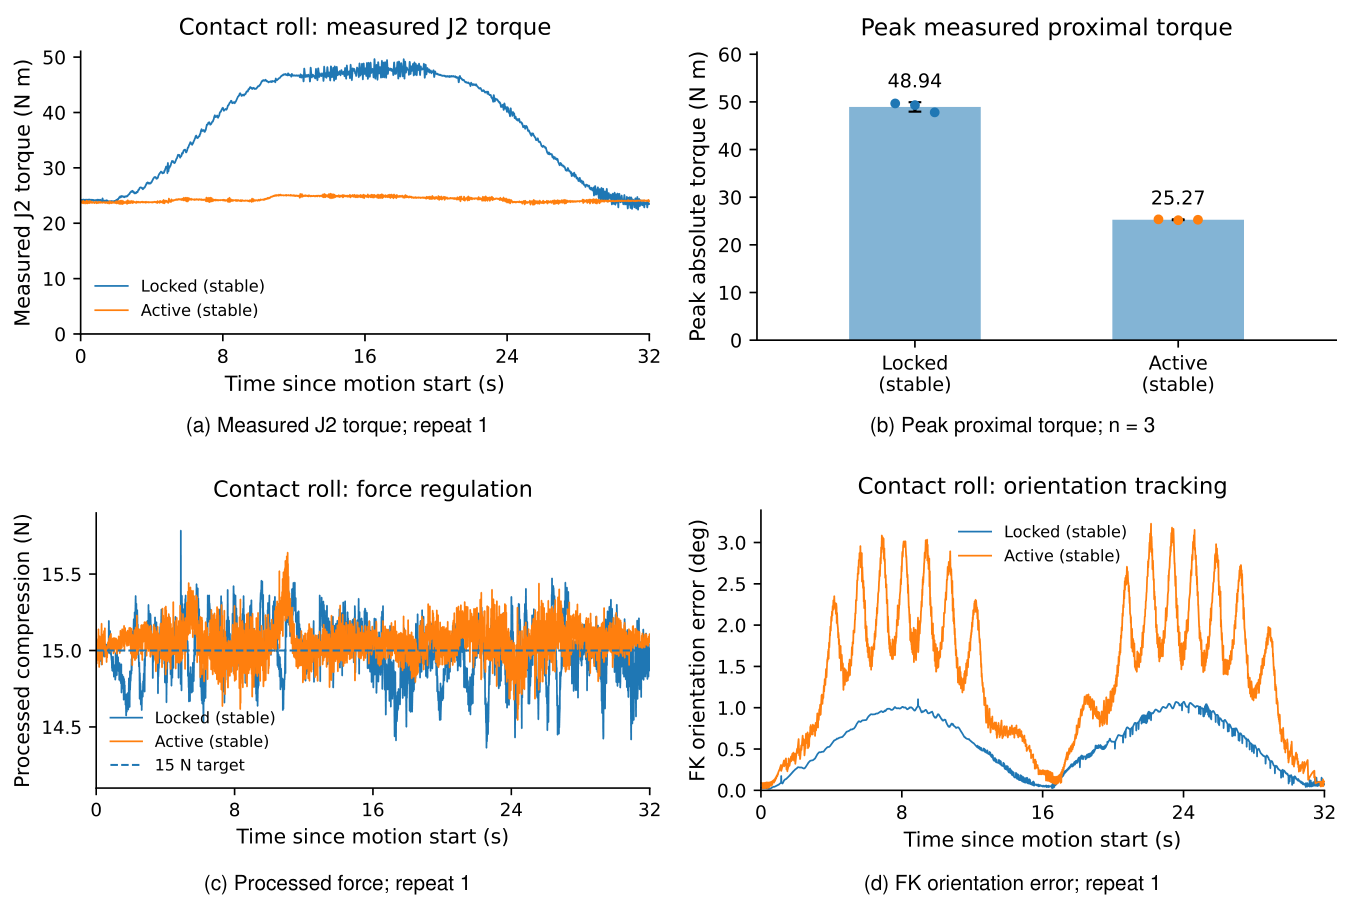
media/figures/contact-roll.png
