RuggedizedWrist/RuggedizedWrist.github.io/media/figures/motion-7dof-pitch.png

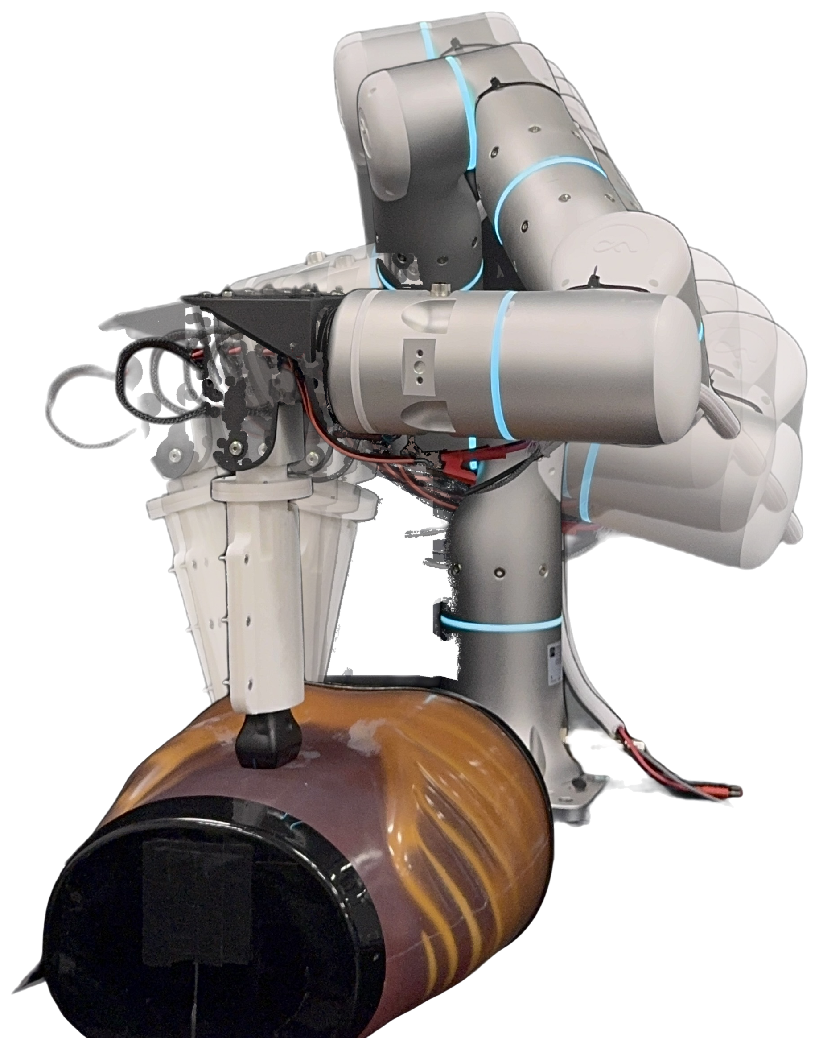
media/figures/motion-7dof-pitch.png
