RuggedizedWrist/RuggedizedWrist.github.io/media/figures/motion-7dof-roll.png

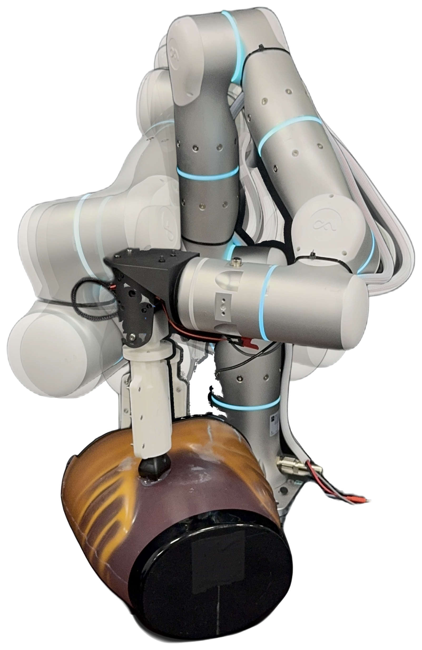
media/figures/motion-7dof-roll.png
