RuggedizedWrist/RuggedizedWrist.github.io/media/figures/motion-9dof-pitch.png

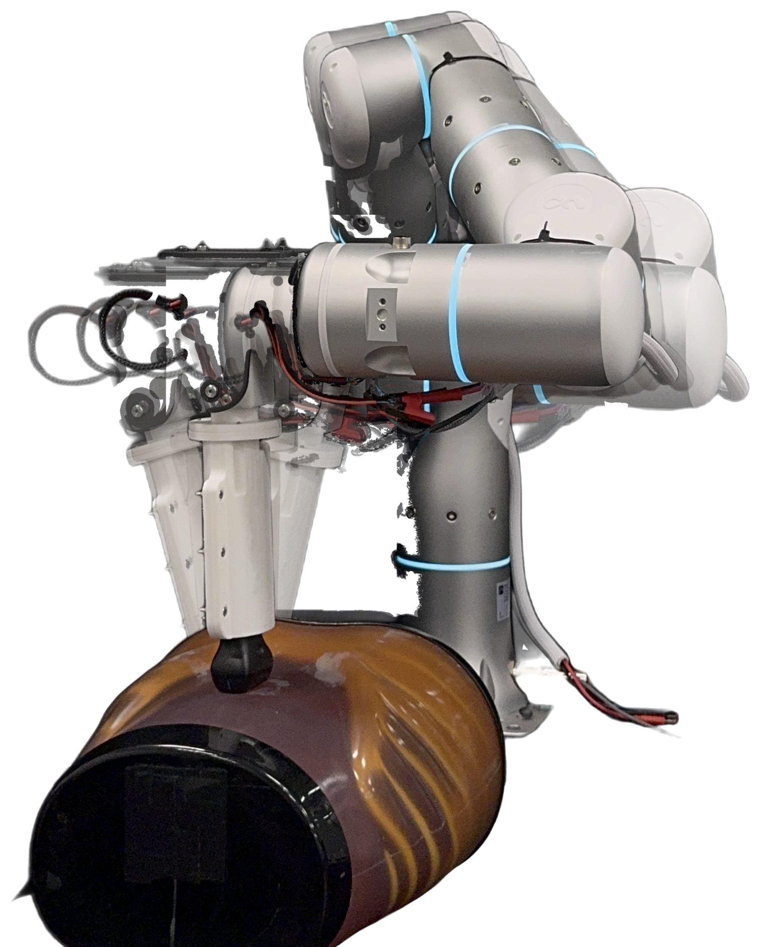
media/figures/motion-9dof-pitch.png
