RuggedizedWrist/RuggedizedWrist.github.io/media/figures/motion-9dof-roll.png

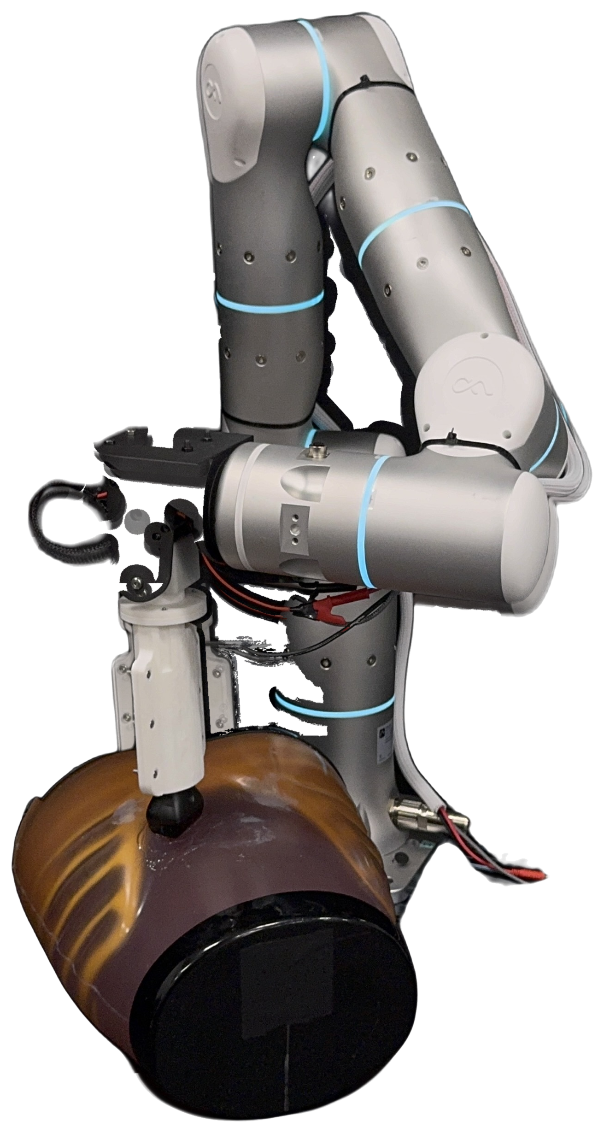
media/figures/motion-9dof-roll.png
