RuggedizedWrist/RuggedizedWrist.github.io/media/figures/overview.png

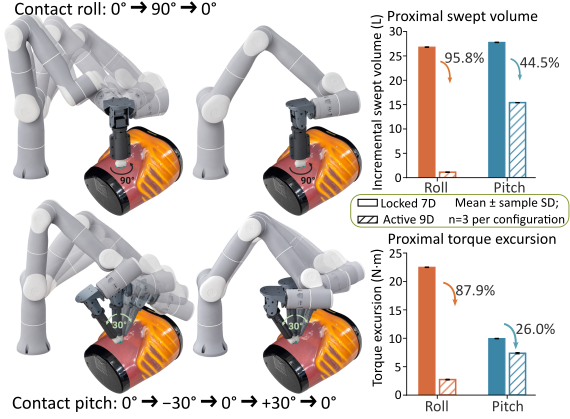
media/figures/overview.png
