RuggedizedWrist/RuggedizedWrist.github.io/media/heart-7dof.gif

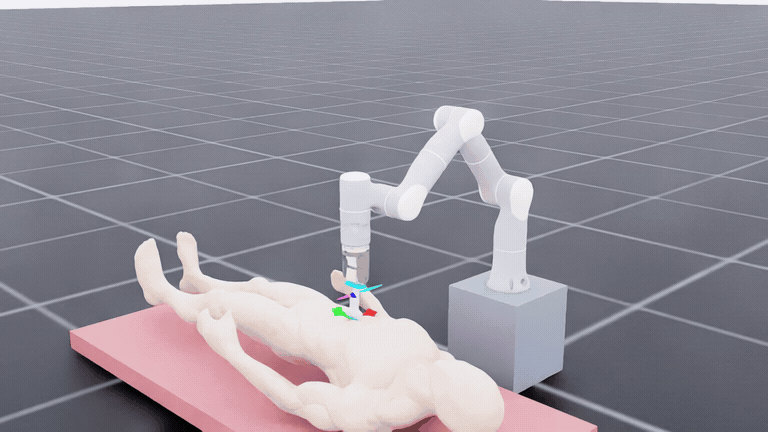
media/heart-7dof.gif
