RuggedizedWrist/RuggedizedWrist.github.io/media/heart-9dof.gif

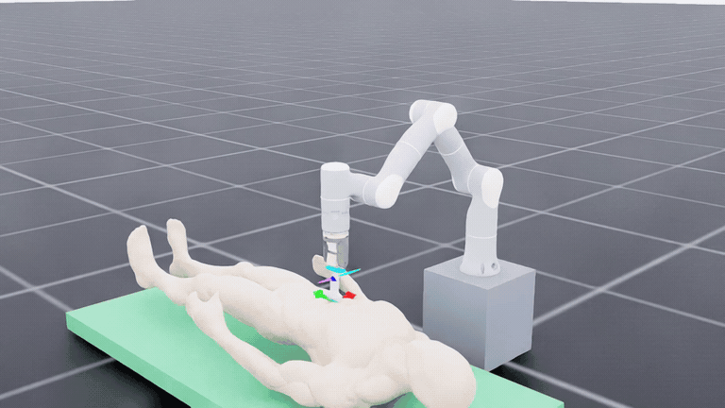
media/heart-9dof.gif
