RuggedizedWrist/RuggedizedWrist.github.io/media/posters/contact-pitch-active.jpg

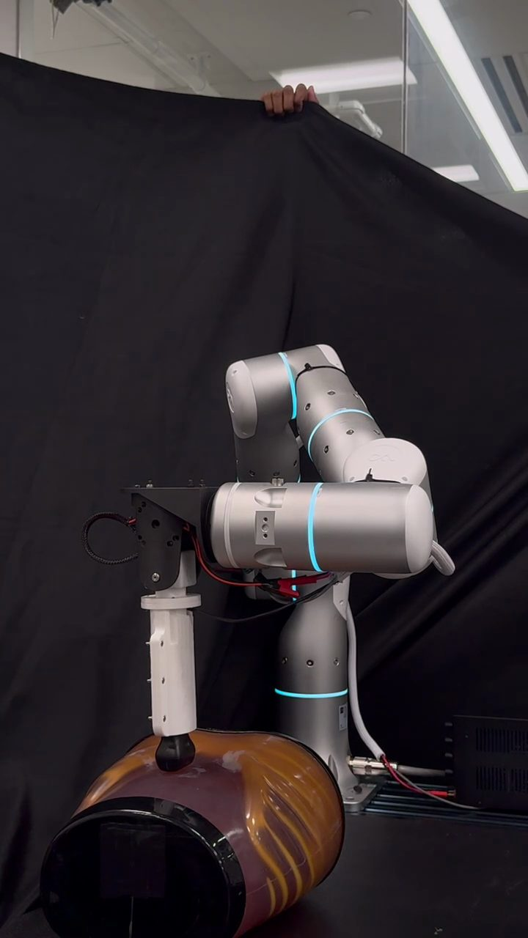
media/posters/contact-pitch-active.jpg
