RuggedizedWrist/RuggedizedWrist.github.io/media/posters/final.jpg

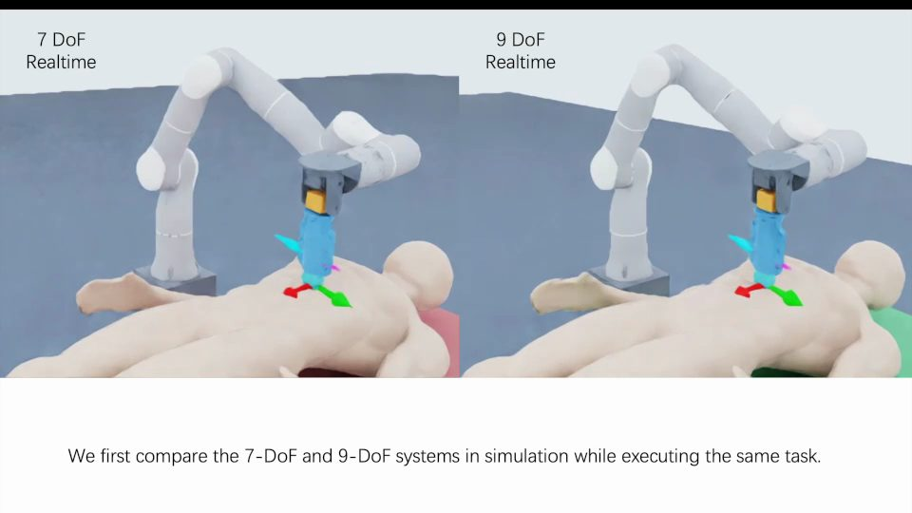
media/posters/final.jpg
