RuggedizedWrist/RuggedizedWrist.github.io/media/posters/pitch-active.jpg

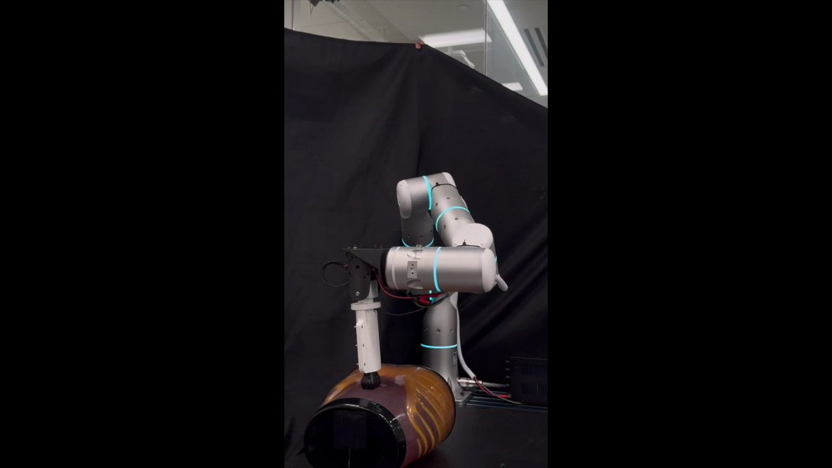
media/posters/pitch-active.jpg
