RuggedizedWrist/RuggedizedWrist.github.io/media/posters/roll-active.jpg

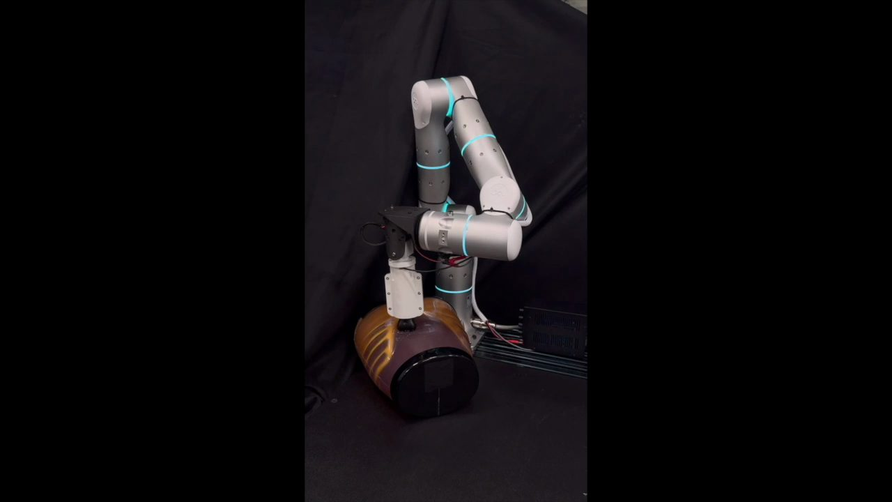
media/posters/roll-active.jpg
