RuggedizedWrist/RuggedizedWrist.github.io/media/posters/sim-active.jpg

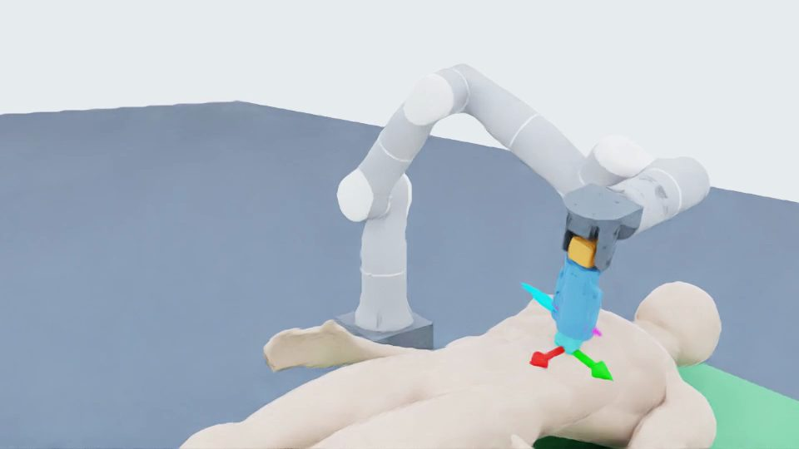
media/posters/sim-active.jpg
