RuggedizedWrist/RuggedizedWrist.github.io/media/posters/sim-locked.jpg

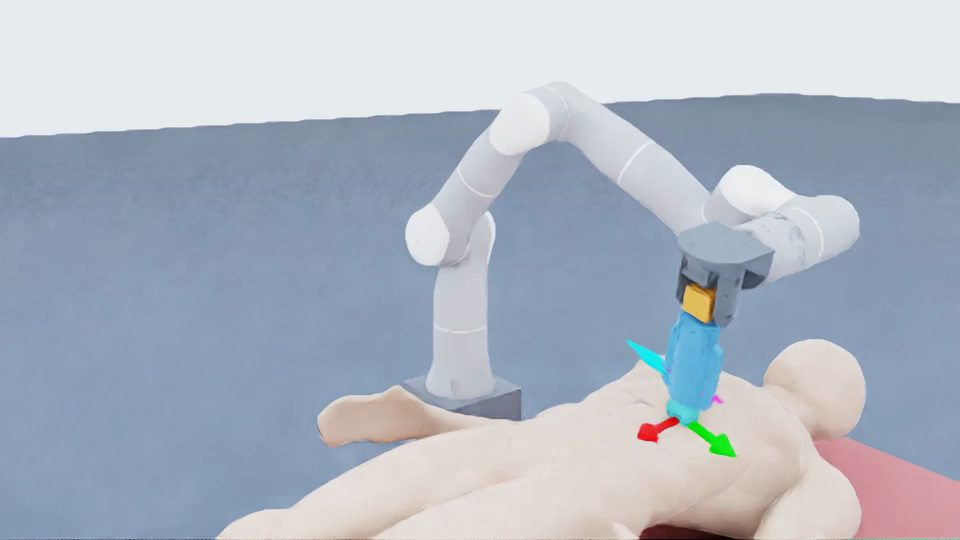
media/posters/sim-locked.jpg
