RuggedizedWrist/RuggedizedWrist.github.io/media/results/hydro15-overview-raw.png

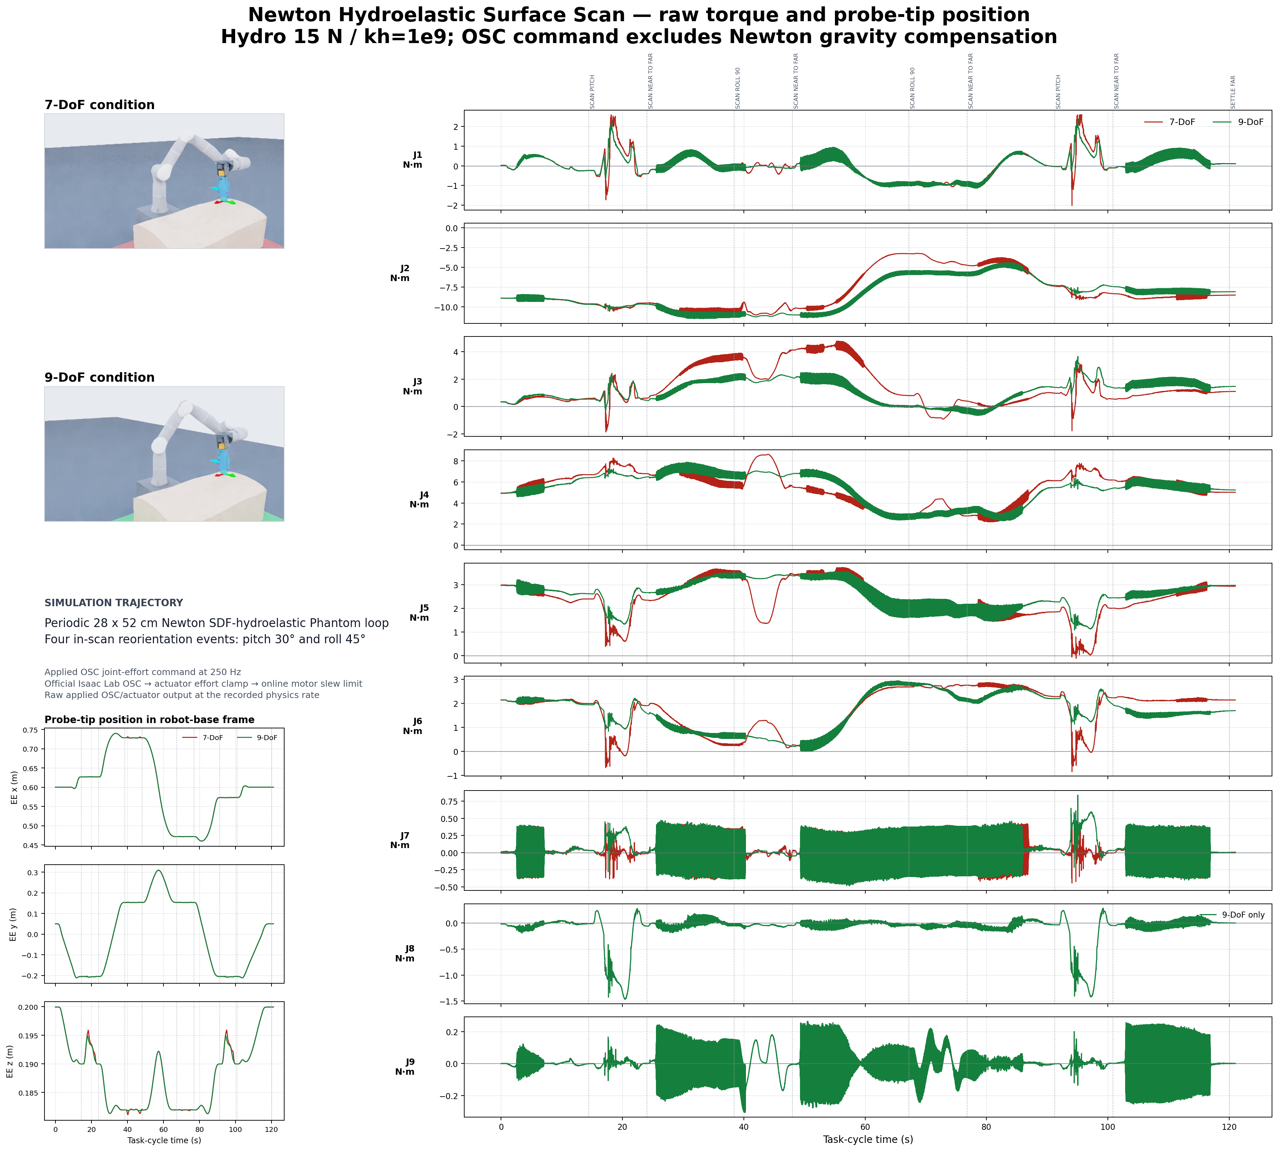
media/results/hydro15-overview-raw.png
