RuggedizedWrist/RuggedizedWrist.github.io/media/results/hydro15-overview-smoothed.png

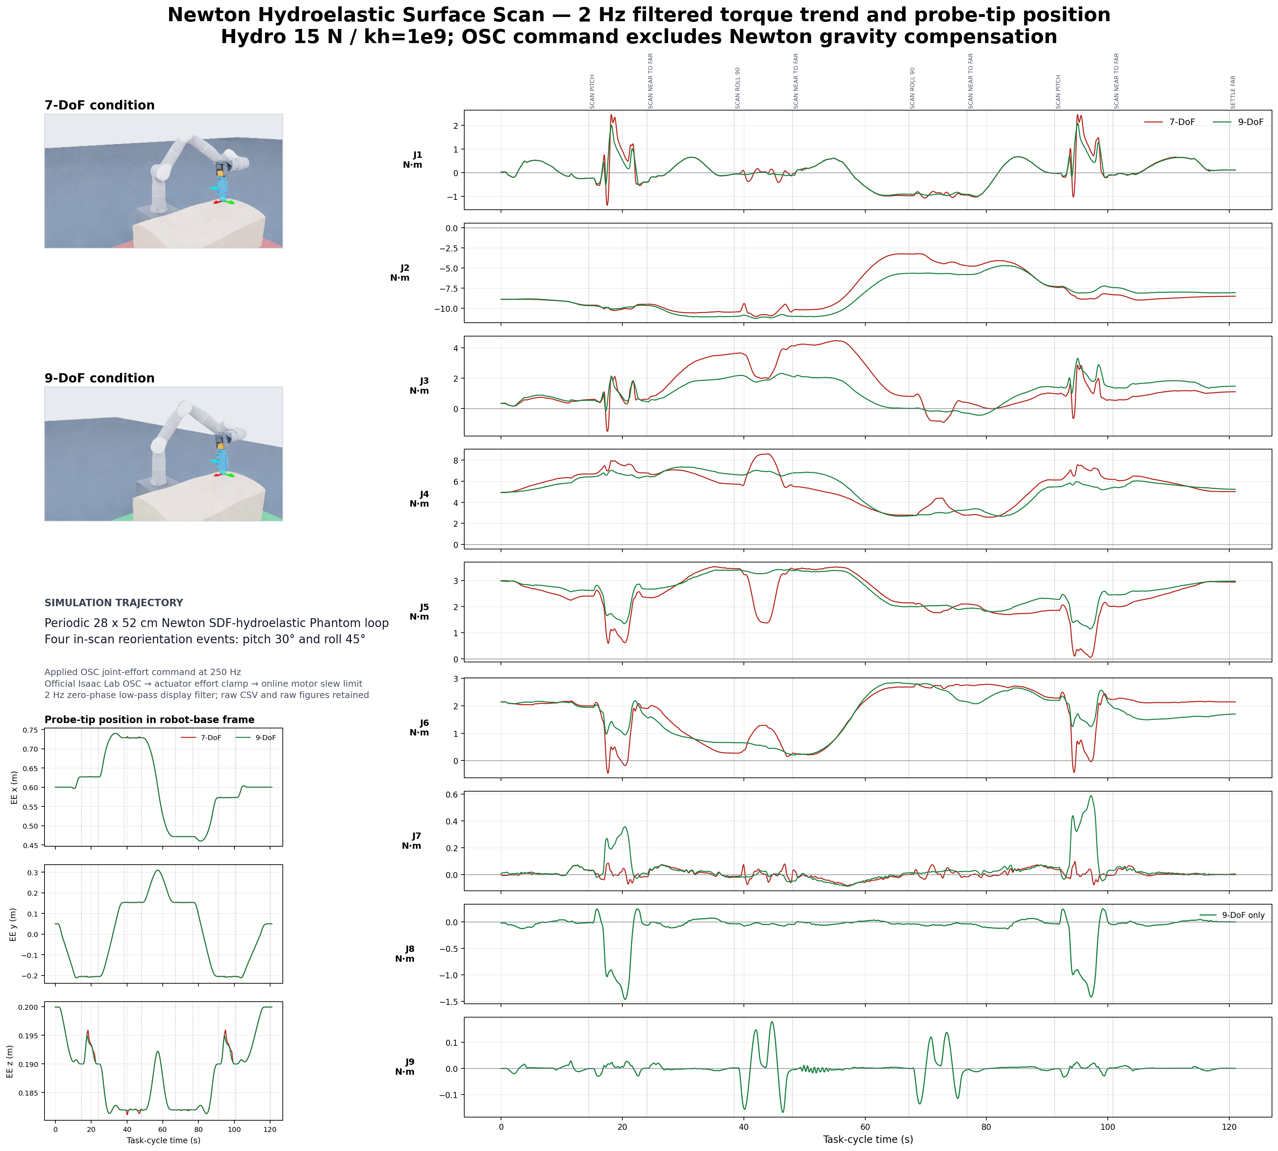
media/results/hydro15-overview-smoothed.png
