RuggedizedWrist/RuggedizedWrist.github.io/media/results/mount-v6/posters/cardiac-9dof.png

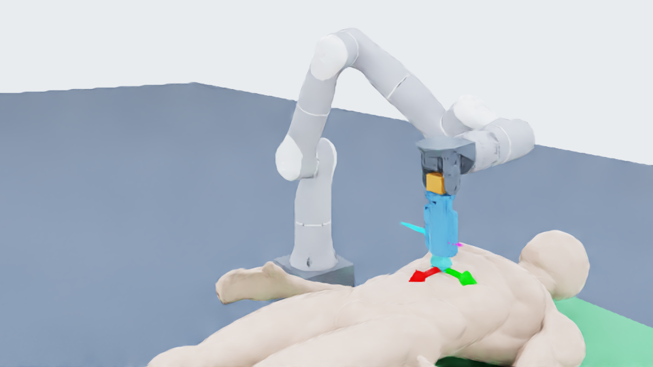
media/results/mount-v6/posters/cardiac-9dof.png
