RuggedizedWrist/RuggedizedWrist.github.io/media/results/mount-v6/posters/cross-waist-7dof.png

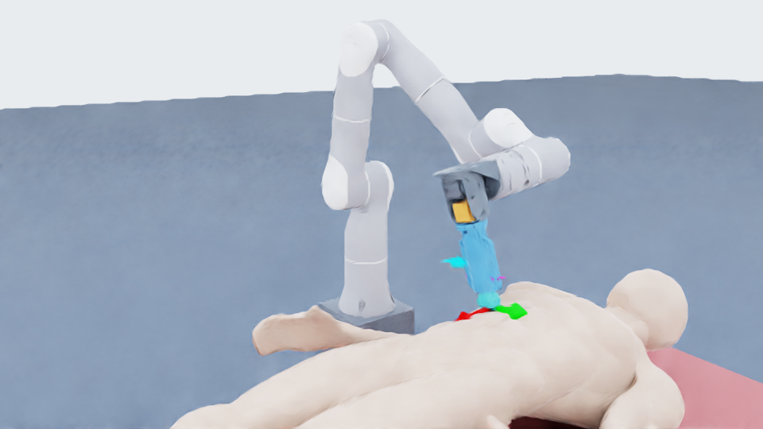
media/results/mount-v6/posters/cross-waist-7dof.png
