RuggedizedWrist/RuggedizedWrist.github.io/media/results/mount-v6/posters/near-to-far-9dof.png

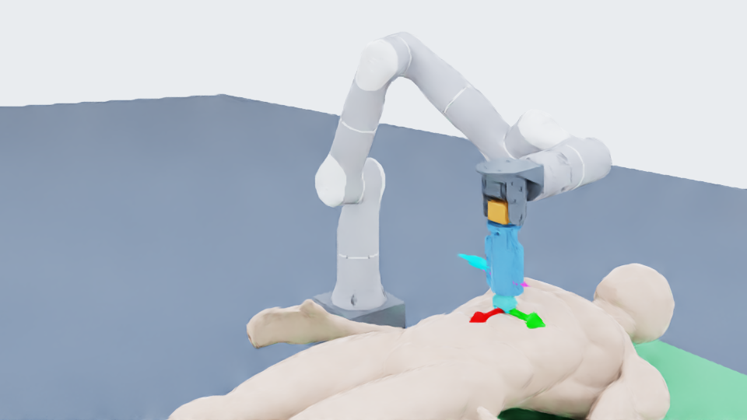
media/results/mount-v6/posters/near-to-far-9dof.png
