RuggedizedWrist/RuggedizedWrist.github.io/media/results/posters/cardiac-9dof.jpg

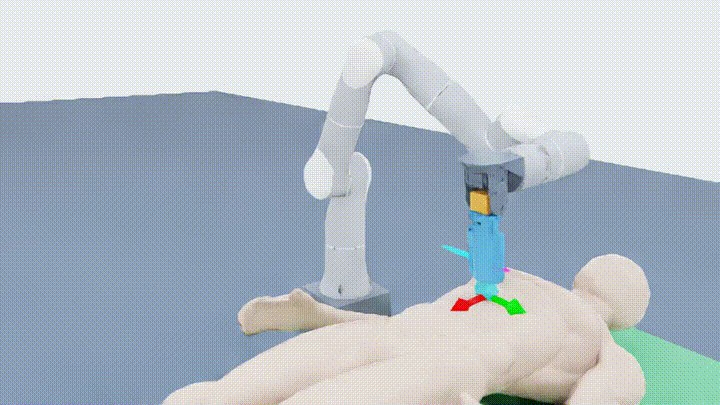
media/results/posters/cardiac-9dof.jpg
