RuggedizedWrist/RuggedizedWrist.github.io/models/urdf/original-stl-v1/_3D______5044_5600_6709_2023_10_245047_7.stl

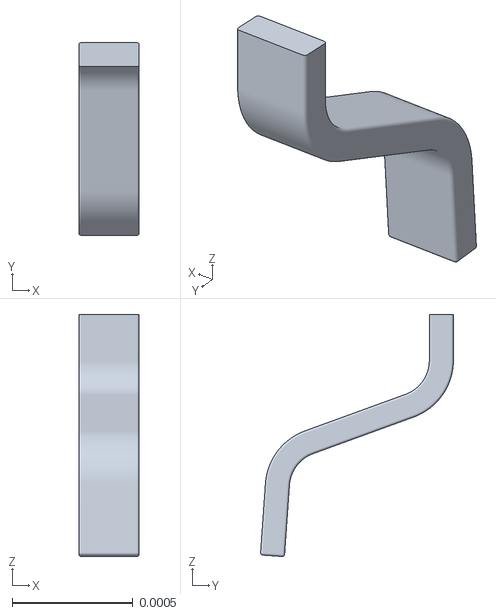
[picture p33: CAD file, 2026-09-11]
models/urdf/original-stl-v1/_3D______5044_5600_6709_2023_10_245047_7.stl
0.00025 x 0.000799 x 0.001
