RuggedizedWrist/RuggedizedWrist.github.io/models/urdf/original-web-meshes-v1/roll_motor_bracket_anonymous.stl

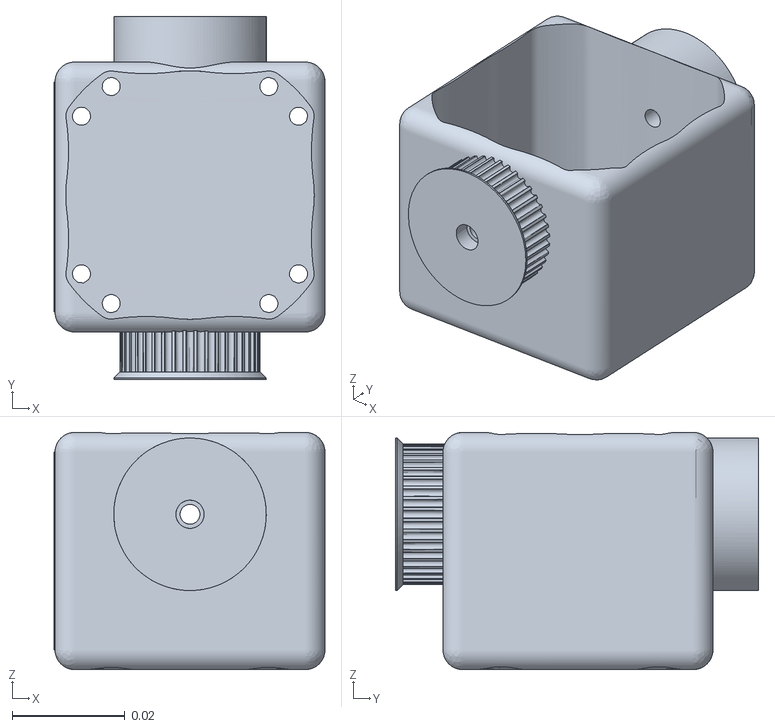
[picture p34: CAD file, 2026-09-16]
models/urdf/original-web-meshes-v1/roll_motor_bracket_anonymous.stl
0.048 x 0.0644 x 0.042
