RuggedizedWrist/RuggedizedWrist.github.io/models/urdf/original-web-meshes-v1/pitch_pulley.stl

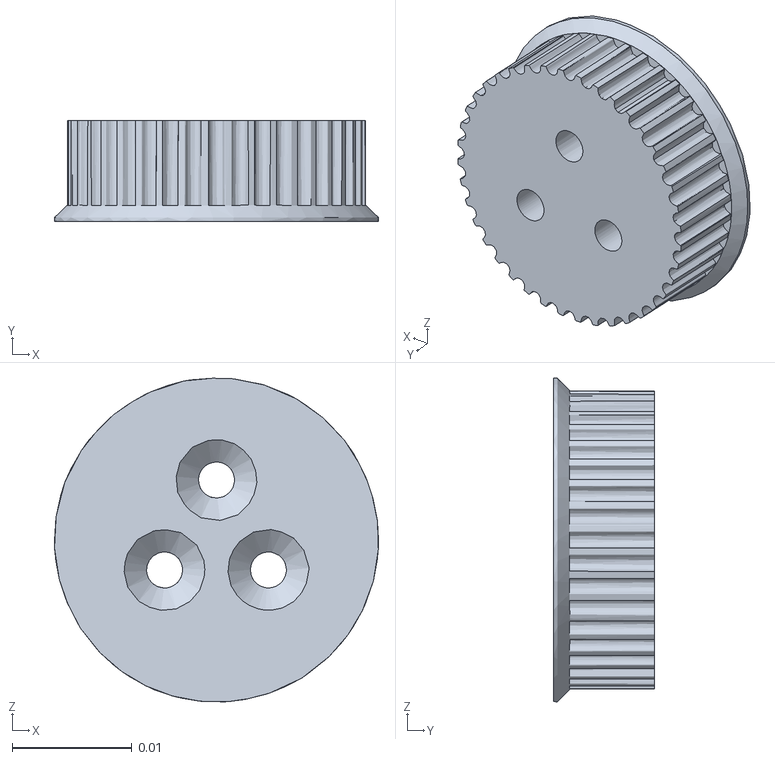
[picture p35: CAD file, 2026-09-11]
models/urdf/original-web-meshes-v1/pitch_pulley.stl
0.027 x 0.00845 x 0.027
