RuggedizedWrist/RuggedizedWrist.github.io/models/urdf/original-stl-v1/_3D______5044_5600_6709_2023_10_245047_145.stl

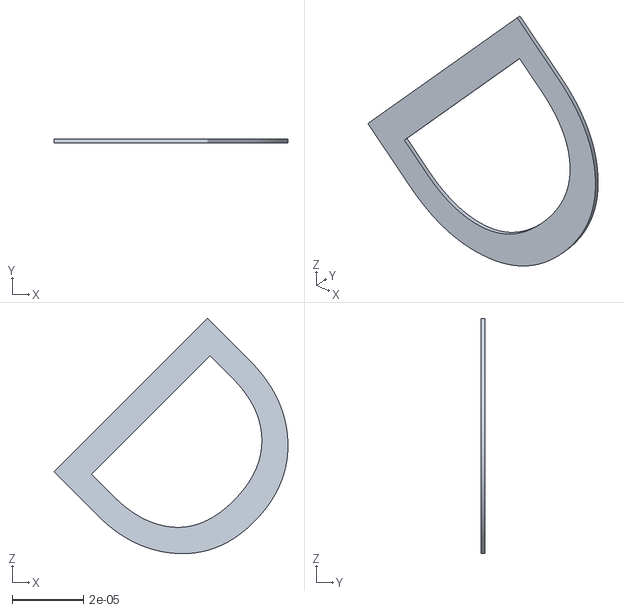
[picture p36: CAD file, 2026-09-11]
models/urdf/original-stl-v1/_3D______5044_5600_6709_2023_10_245047_145.stl
6.57e-05 x 1e-06 x 6.61e-05
