RuggedizedWrist/RuggedizedWrist.github.io/models/urdf/original-web-meshes-v1/pitch_pulley_connector.stl

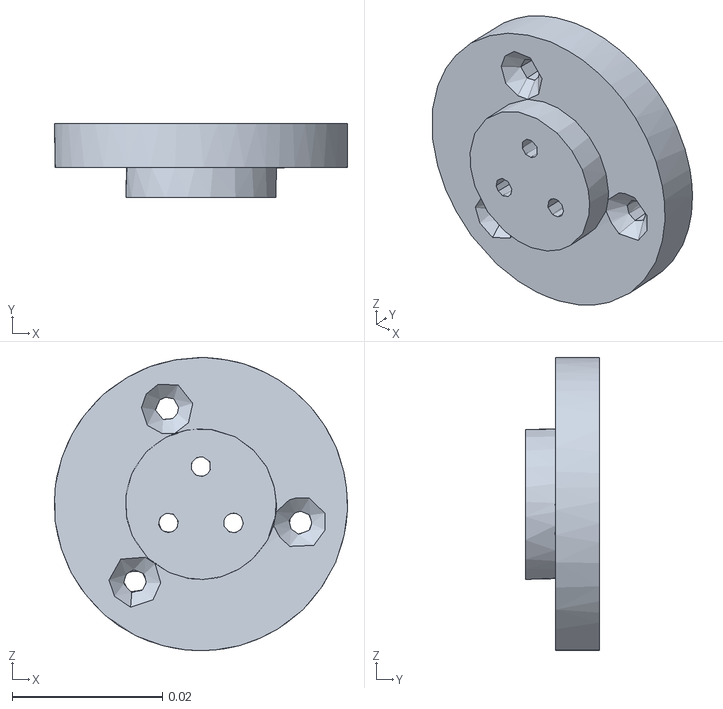
[picture p37: CAD file, 2026-09-11]
models/urdf/original-web-meshes-v1/pitch_pulley_connector.stl
0.039 x 0.0099 x 0.0391
