RuggedizedWrist/RuggedizedWrist.github.io/models/urdf/original-stl-v1/_3D______5044_5600_6709_2023_10_245047_53.stl

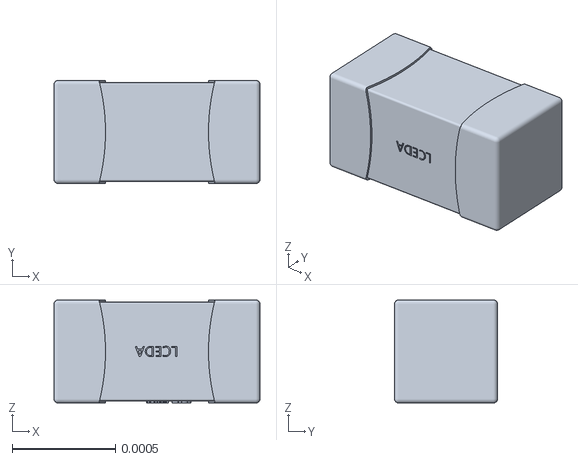
[picture p38: CAD file, 2026-09-11]
models/urdf/original-stl-v1/_3D______5044_5600_6709_2023_10_245047_53.stl
0.001 x 0.0005 x 0.0005
