RuggedizedWrist/RuggedizedWrist.github.io/models/urdf/original-web-meshes-v1/roll_output.stl

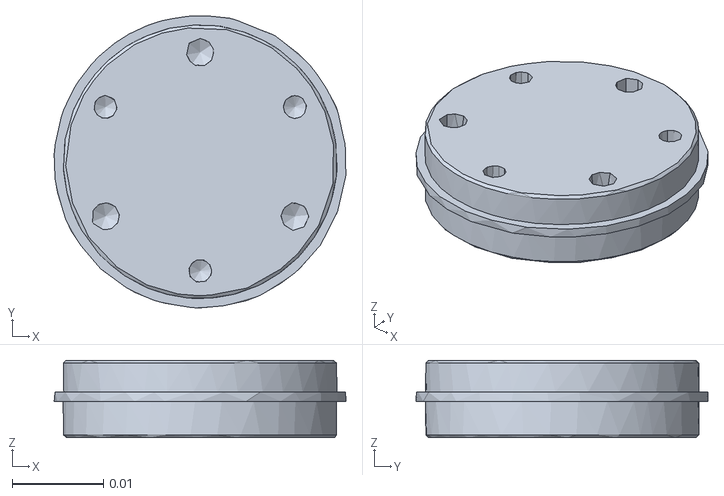
[picture p39: CAD file, 2026-09-11]
models/urdf/original-web-meshes-v1/roll_output.stl
0.032 x 0.0321 x 0.0085
