RuggedizedWrist/RuggedizedWrist.github.io/models/urdf/original-web-meshes-v1/gecko_attachment.stl

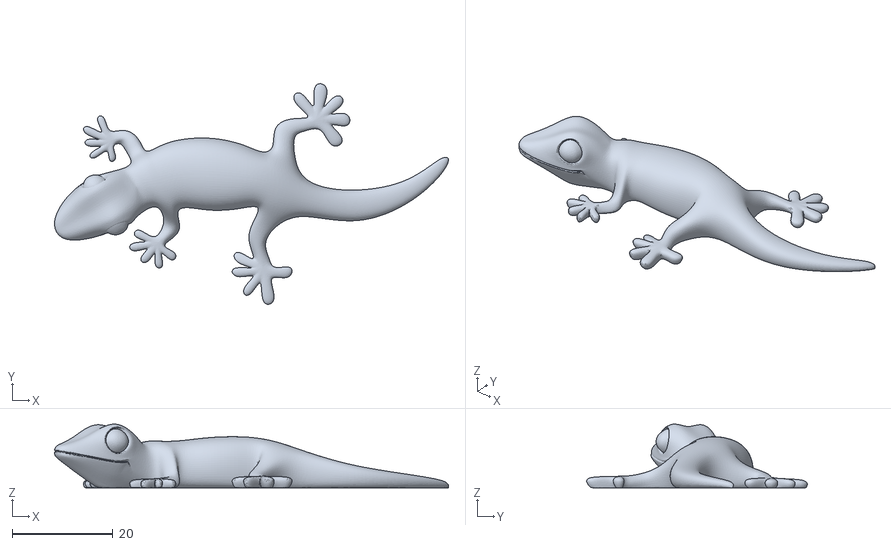
[picture p40: CAD file, 2026-09-11]
models/urdf/original-web-meshes-v1/gecko_attachment.stl
78.2 x 43.8 x 12.7
