RuggedizedWrist/RuggedizedWrist.github.io/models/urdf/original-stl-v1/_3D______5044_5600_6709_2023_10_245047_62.stl

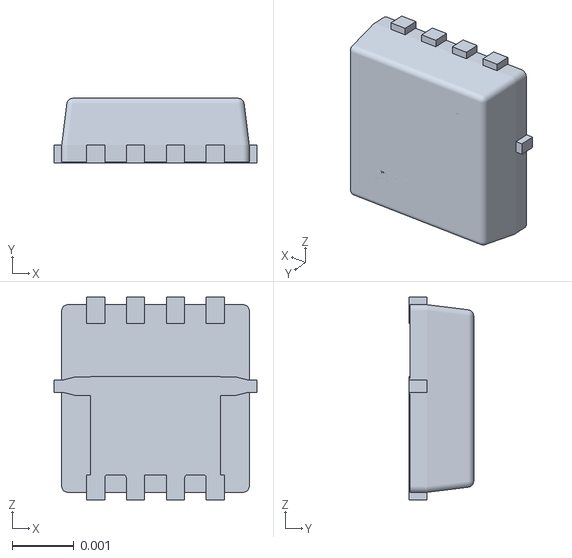
[picture p41: CAD file, 2026-09-11]
models/urdf/original-stl-v1/_3D______5044_5600_6709_2023_10_245047_62.stl
0.0033 x 0.00105 x 0.0033
