RuggedizedWrist/RuggedizedWrist.github.io/models/urdf/original-web-meshes-v1/mount_to_arm.stl

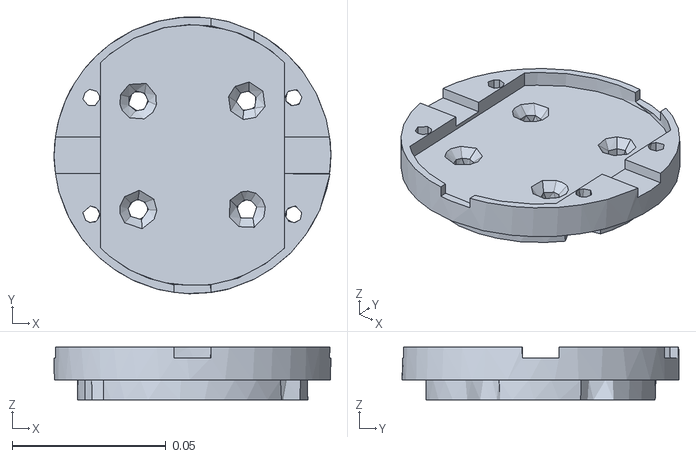
[picture p42: CAD file, 2026-09-11]
models/urdf/original-web-meshes-v1/mount_to_arm.stl
0.0902 x 0.0901 x 0.0173
