RuggedizedWrist/RuggedizedWrist.github.io/models/urdf/original-stl-v1/_3D______5044_5600_6709_2023_10_245047_16.stl

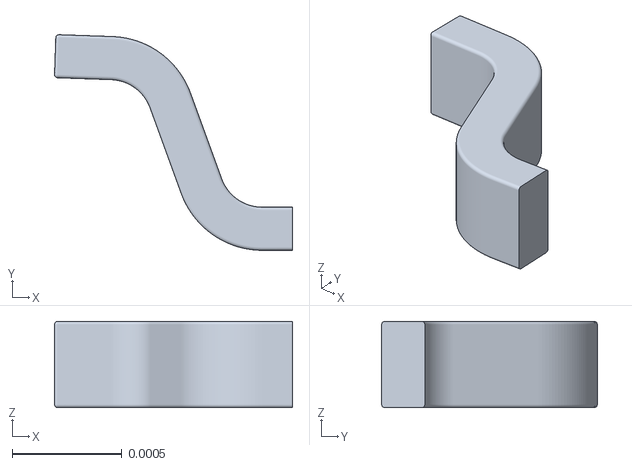
[picture p43: CAD file, 2026-09-11]
models/urdf/original-stl-v1/_3D______5044_5600_6709_2023_10_245047_16.stl
0.00108 x 0.000982 x 0.000393
