RuggedizedWrist/RuggedizedWrist.github.io/models/urdf/original-web-meshes-v1/roll_motor_bracket.stl

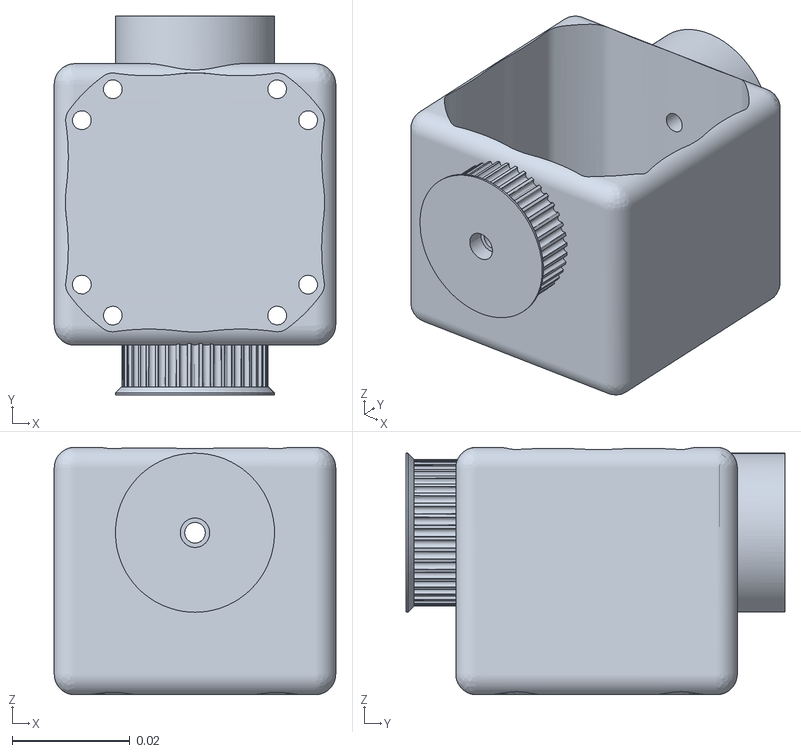
[picture p44: CAD file, 2026-09-11]
models/urdf/original-web-meshes-v1/roll_motor_bracket.stl
0.0478 x 0.0644 x 0.042
