RuggedizedWrist/RuggedizedWrist.github.io/models/urdf/original-web-meshes-v1/roll_motor_housing.stl

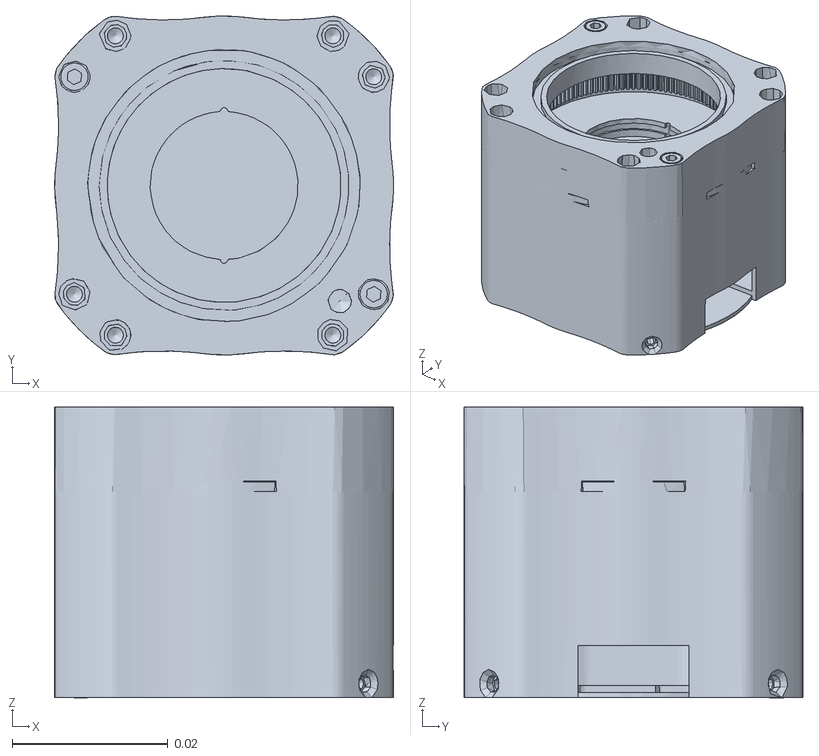
[picture p45: CAD file, 2026-09-11]
models/urdf/original-web-meshes-v1/roll_motor_housing.stl
0.0435 x 0.0435 x 0.0373
