RuggedizedWrist/RuggedizedWrist.github.io/models/urdf/original-web-meshes-v1/wrist_base.stl

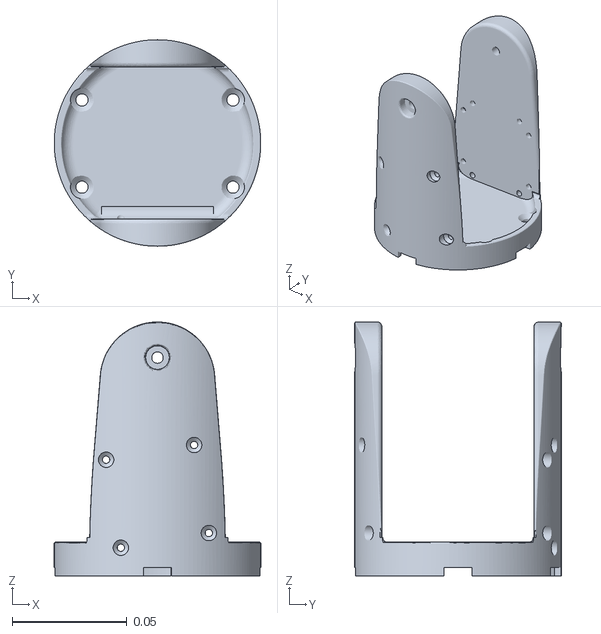
[picture p47: CAD file, 2026-09-11]
models/urdf/original-web-meshes-v1/wrist_base.stl
0.09 x 0.09 x 0.111
