RuggedizedWrist/RuggedizedWrist.github.io/models/urdf/original-stl-v1/_______1.stl

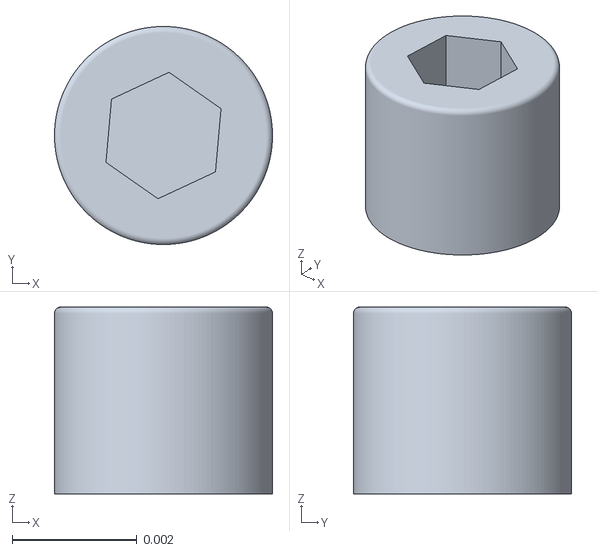
[picture p58: CAD file, 2026-09-11]
models/urdf/original-stl-v1/_______1.stl
0.0035 x 0.0035 x 0.003
