RuggedizedWrist/RuggedizedWrist.github.io/models/urdf/original-stl-v1/____44380227.stl

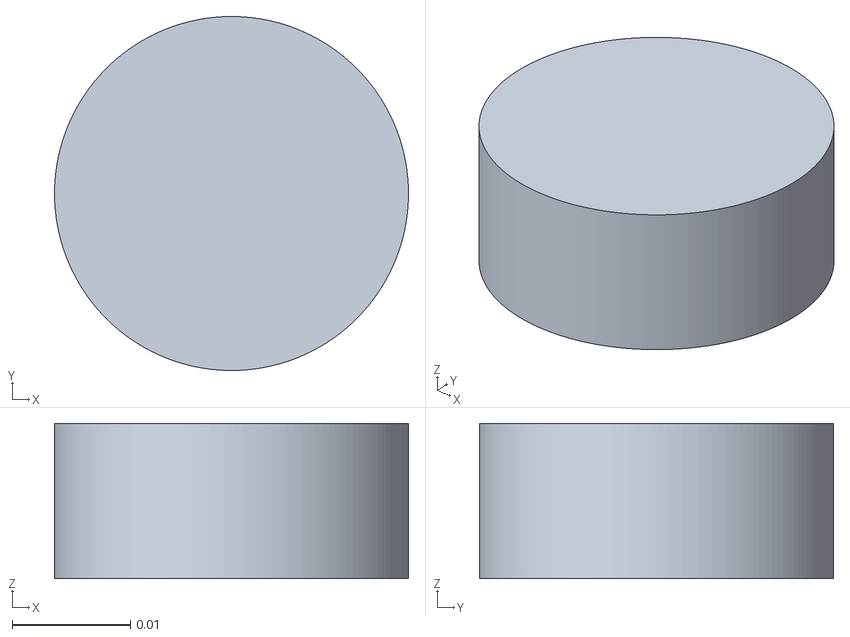
[picture p74: CAD file, 2026-09-11]
models/urdf/original-stl-v1/____44380227.stl
0.03 x 0.03 x 0.0131
