RuggedizedWrist/RuggedizedWrist.github.io/models/urdf/original-stl-v1/__________4438.stl

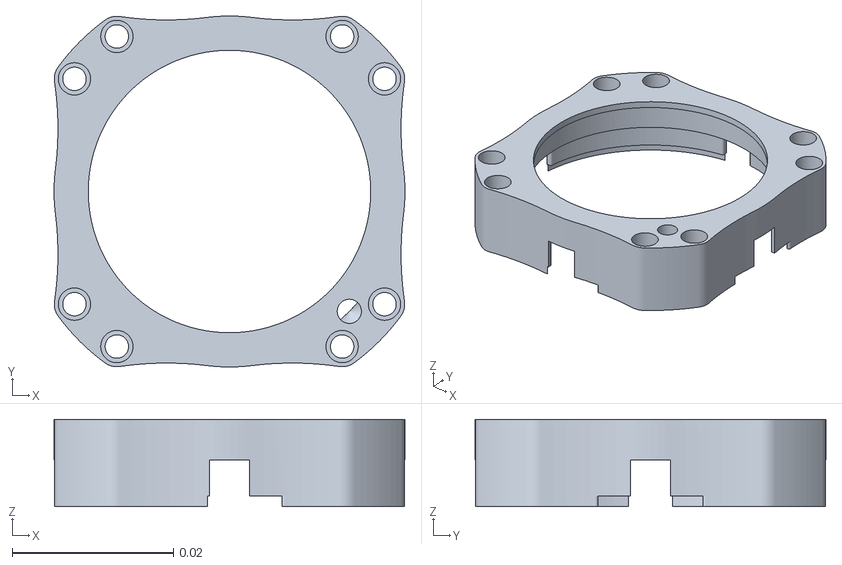
[picture p75: CAD file, 2026-09-11]
models/urdf/original-stl-v1/__________4438.stl
0.0435 x 0.0435 x 0.0108
