RuggedizedWrist/RuggedizedWrist.github.io/models/urdf/original-stl-v1/_2____44380227.stl

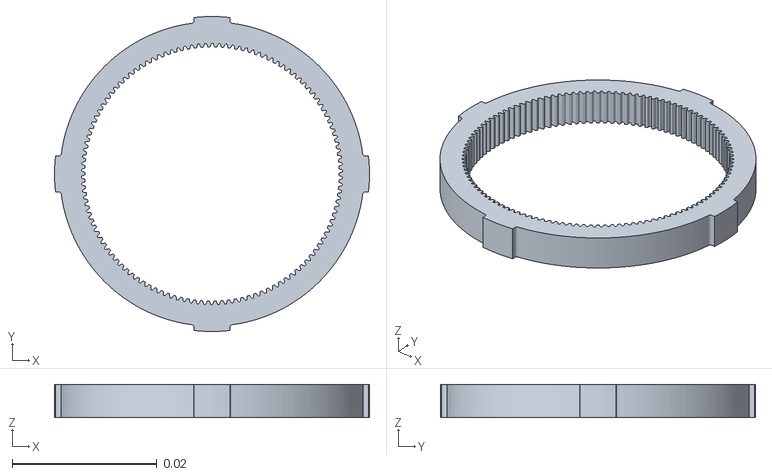
[picture p82: CAD file, 2026-09-11]
models/urdf/original-stl-v1/_2____44380227.stl
0.0435 x 0.0435 x 0.0046
