RuggedizedWrist/RuggedizedWrist.github.io/models/urdf/original-stl-v1/KAA15CL0a5047.stl

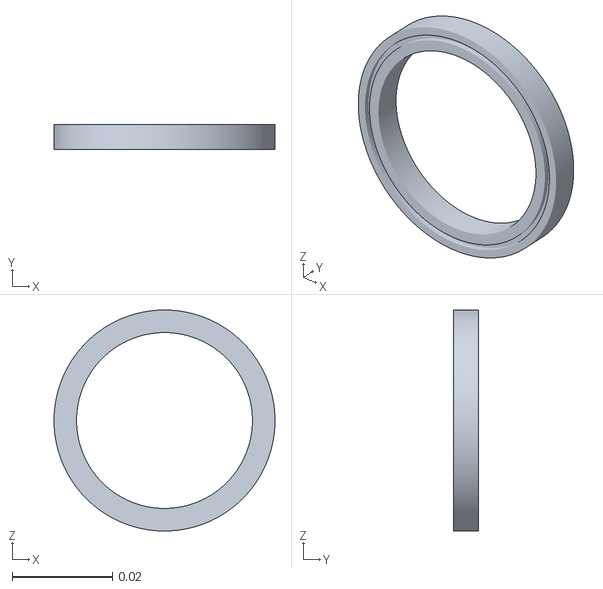
[picture p84: CAD file, 2026-09-11]
models/urdf/original-stl-v1/KAA15CL0a5047.stl
0.044 x 0.005 x 0.044
