RuggedizedWrist/RuggedizedWrist.github.io/(list of files, cad)

Other CAD files:
models/urdf/original-stl-v1/_3D______5044_5600_6709_2023_10_245047_104.stl
models/urdf/original-stl-v1/_3D______5044_5600_6709_2023_10_245047_5.stl
models/urdf/original-stl-v1/_3D______5044_5600_6709_2023_10_245047_158.stl
models/urdf/original-stl-v1/_3D______5044_5600_6709_2023_10_245047_204.stl
models/urdf/original-web-meshes-v1/empty.stl
models/urdf/original-stl-v1/_3D______5044_5600_6709_2023_10_245047_20.stl
models/urdf/original-stl-v1/_3D______5044_5600_6709_2023_10_245047_94.stl
models/urdf/original-stl-v1/_3D______5044_5600_6709_2023_10_245047_9.stl
models/urdf/original-stl-v1/_3D______5044_5600_6709_2023_10_245047_25.stl
models/urdf/original-stl-v1/_3D______5044_5600_6709_2023_10_245047_32.stl
models/urdf/original-stl-v1/_3D______5044_5600_6709_2023_10_245047_70.stl
models/urdf/original-stl-v1/_3D______5044_5600_6709_2023_10_245047_129.stl
models/urdf/original-stl-v1/_3D______5044_5600_6709_2023_10_245047_209.stl
models/urdf/original-stl-v1/_3D______5044_5600_6709_2023_10_245047_6.stl
models/urdf/original-stl-v1/_3D______5044_5600_6709_2023_10_245047_213.stl
models/urdf/original-stl-v1/_3D______5044_5600_6709_2023_10_245047_217.stl
models/urdf/original-stl-v1/PitchMotorPulley.stl
models/urdf/original-stl-v1/_3D______5044_5600_6709_2023_10_245047_155.stl
models/urdf/original-stl-v1/_3D______5044_5600_6709_2023_10_245047_66.stl
models/urdf/original-stl-v1/_3D______5044_5600_6709_2023_10_245047_117.stl
models/urdf/original-stl-v1/_3D______5044_5600_6709_2023_10_245047_73.stl
models/urdf/original-stl-v1/_3D______5044_5600_6709_2023_10_245047_57.stl
models/urdf/original-stl-v1/_3D______5044_5600_6709_2023_10_245047_150.stl
models/urdf/original-stl-v1/_3D______5044_5600_6709_2023_10_245047_125.stl
models/urdf/original-stl-v1/_3D______5044_5600_6709_2023_10_245047_19.stl
models/urdf/original-stl-v1/_3D______5044_5600_6709_2023_10_245047_95.stl
models/urdf/original-stl-v1/_3D______5044_5600_6709_2023_10_245047_84.stl
models/urdf/original-stl-v1/_3D______5044_5600_6709_2023_10_245047_130.stl
models/urdf/original-stl-v1/_3D______5044_5600_6709_2023_10_245047_2.stl
models/urdf/original-stl-v1/_3D______5044_5600_6709_2023_10_245047_138.stl
models/urdf/original-stl-v1/_3D______5044_5600_6709_2023_10_245047_151.stl
models/urdf/original-stl-v1/_3D______5044_5600_6709_2023_10_245047_115.stl
models/urdf/original-stl-v1/_3D______5044_5600_6709_2023_10_245047_140.stl
models/urdf/original-stl-v1/_3D______5044_5600_6709_2023_10_245047_176.stl
models/urdf/original-stl-v1/gecko-original.stl
models/urdf/original-stl-v1/_3D______5044_5600_6709_2023_10_245047_101.stl
models/urdf/original-stl-v1/_3D______5044_5600_6709_2023_10_245047_52.stl
models/urdf/original-stl-v1/_3D______5044_5600_6709_2023_10_245047_61.stl
models/urdf/original-stl-v1/_3D______5044_5600_6709_2023_10_245047_21.stl
models/urdf/original-stl-v1/_3D______5044_5600_6709_2023_10_245047_192.stl
models/urdf/original-stl-v1/_3D______5044_5600_6709_2023_10_245047_118.stl
models/urdf/original-stl-v1/_3D______5044_5600_6709_2023_10_245047_10.stl
models/urdf/original-stl-v1/_3D______5044_5600_6709_2023_10_245047_14.stl
models/urdf/original-stl-v1/_3D______5044_5600_6709_2023_10_245047_210.stl
models/urdf/original-stl-v1/_3D______5044_5600_6709_2023_10_245047_162.stl
models/urdf/original-stl-v1/_3D______5044_5600_6709_2023_10_245047_31.stl
models/urdf/original-stl-v1/_3D______5044_5600_6709_2023_10_245047_92.stl
models/urdf/original-stl-v1/_3D______5044_5600_6709_2023_10_245047_99.stl
models/urdf/original-stl-v1/_3D______5044_5600_6709_2023_10_245047_58.stl
models/urdf/original-stl-v1/_3D______5044_5600_6709_2023_10_245047_137.stl
models/urdf/original-stl-v1/_3D______5044_5600_6709_2023_10_245047_179.stl
models/urdf/original-stl-v1/_3D______5044_5600_6709_2023_10_245047_103.stl
models/urdf/original-stl-v1/_3D______5044_5600_6709_2023_10_245047_202.stl
models/urdf/original-stl-v1/_3D______5044_5600_6709_2023_10_245047_63.stl
models/urdf/original-stl-v1/_3D______5044_5600_6709_2023_10_245047_121.stl
models/urdf/original-stl-v1/_3D______5044_5600_6709_2023_10_245047_8.stl
models/urdf/original-stl-v1/_3D______5044_5600_6709_2023_10_245047_175.stl
models/urdf/original-stl-v1/_3D______5044_5600_6709_2023_10_245047_111.stl
models/urdf/original-stl-v1/_3D______5044_5600_6709_2023_10_245047_71.stl
models/urdf/original-stl-v1/_3D______5044_5600_6709_2023_10_245047_46.stl
models/urdf/original-stl-v1/_3D______5044_5600_6709_2023_10_245047_77.stl
models/urdf/original-stl-v1/_3D______5044_5600_6709_2023_10_245047_191.stl
models/urdf/original-stl-v1/_3D______5044_5600_6709_2023_10_245047_127.stl
models/urdf/original-stl-v1/_3D______5044_5600_6709_2023_10_245047_200.stl
models/urdf/original-stl-v1/_3D______5044_5600_6709_2023_10_245047_68.stl
models/urdf/original-stl-v1/_3D______5044_5600_6709_2023_10_245047_108.stl
models/urdf/original-stl-v1/_3D______5044_5600_6709_2023_10_245047_78.stl
models/urdf/original-stl-v1/_3D______5044_5600_6709_2023_10_245047_96.stl
models/urdf/original-stl-v1/_3D______5044_5600_6709_2023_10_245047_199.stl
models/urdf/original-stl-v1/_3D______5044_5600_6709_2023_10_245047_89.stl
models/urdf/original-stl-v1/_3D______5044_5600_6709_2023_10_245047_216.stl
models/urdf/original-stl-v1/_3D______5044_5600_6709_2023_10_245047_126.stl
models/urdf/original-stl-v1/_3D______5044_5600_6709_2023_10_245047_79.stl
models/urdf/original-stl-v1/_3D______5044_5600_6709_2023_10_245047_165.stl
models/urdf/original-stl-v1/_3D______5044_5600_6709_2023_10_245047_22.stl
models/urdf/original-stl-v1/_3D______5044_5600_6709_2023_10_245047_181.stl
models/urdf/original-stl-v1/_3D______5044_5600_6709_2023_10_245047_160.stl
models/urdf/original-stl-v1/_3D______5044_5600_6709_2023_10_245047_142.stl
models/urdf/original-stl-v1/_3D______5044_5600_6709_2023_10_245047_28.stl
models/urdf/original-stl-v1/_3D______5044_5600_6709_2023_10_245047_3.stl
models/urdf/original-stl-v1/_3D______5044_5600_6709_2023_10_245047_182.stl
models/urdf/original-stl-v1/_3D______5044_5600_6709_2023_10_245047_183.stl
models/urdf/original-stl-v1/_3D______5044_5600_6709_2023_10_245047_197.stl
models/urdf/original-stl-v1/_3D______5044_5600_6709_2023_10_245047_55.stl
models/urdf/original-stl-v1/_3D______5044_5600_6709_2023_10_245047_82.stl
models/urdf/original-stl-v1/_3D______5044_5600_6709_2023_10_245047_198.stl
models/urdf/original-stl-v1/_3D______5044_5600_6709_2023_10_245047_49.stl
models/urdf/original-stl-v1/_3D______5044_5600_6709_2023_10_245047_23.stl
models/urdf/original-stl-v1/_3D______5044_5600_6709_2023_10_245047_187.stl
models/urdf/original-stl-v1/_3D______5044_5600_6709_2023_10_245047_97.stl
models/urdf/original-stl-v1/_3D______5044_5600_6709_2023_10_245047_173.stl
models/urdf/original-stl-v1/_3D______5044_5600_6709_2023_10_245047_211.stl
models/urdf/original-stl-v1/_3D______5044_5600_6709_2023_10_245047_188.stl
models/urdf/original-stl-v1/_3D______5044_5600_6709_2023_10_245047_34.stl
models/urdf/original-stl-v1/_3D______5044_5600_6709_2023_10_245047_59.stl
models/urdf/original-stl-v1/_3D______5044_5600_6709_2023_10_245047_112.stl
models/urdf/original-stl-v1/Base.stl
models/urdf/original-stl-v1/PitchMotorPulleyConnector.stl
models/urdf/original-stl-v1/RollMotorBracket.stl
models/urdf/original-stl-v1/_303740227.stl
models/urdf/original-stl-v1/_3D______5044_5600_6709_2023_10_245047.stl
models/urdf/original-stl-v1/_3D______5044_5600_6709_2023_10_245047_1.stl
models/urdf/original-stl-v1/_3D______5044_5600_6709_2023_10_245047_100.stl
models/urdf/original-stl-v1/_3D______5044_5600_6709_2023_10_245047_105.stl
models/urdf/original-stl-v1/_3D______5044_5600_6709_2023_10_245047_106.stl
models/urdf/original-stl-v1/_3D______5044_5600_6709_2023_10_245047_107.stl
models/urdf/original-stl-v1/_3D______5044_5600_6709_2023_10_245047_109.stl
models/urdf/original-stl-v1/_3D______5044_5600_6709_2023_10_245047_11.stl
models/urdf/original-stl-v1/_3D______5044_5600_6709_2023_10_245047_110.stl
models/urdf/original-stl-v1/_3D______5044_5600_6709_2023_10_245047_113.stl
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
