RuggedizedWrist/RuggedizedWrist.github.io/media/results/assembly.png

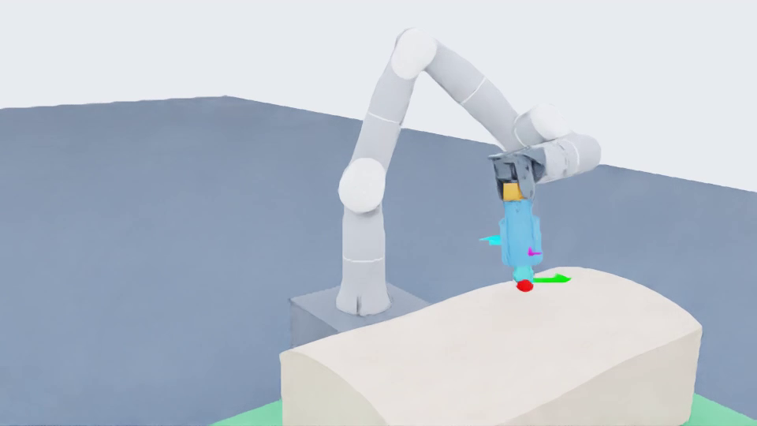
media/results/assembly.png
