RuggedizedWrist/RuggedizedWrist.github.io/media/results/cardiac-7dof.gif

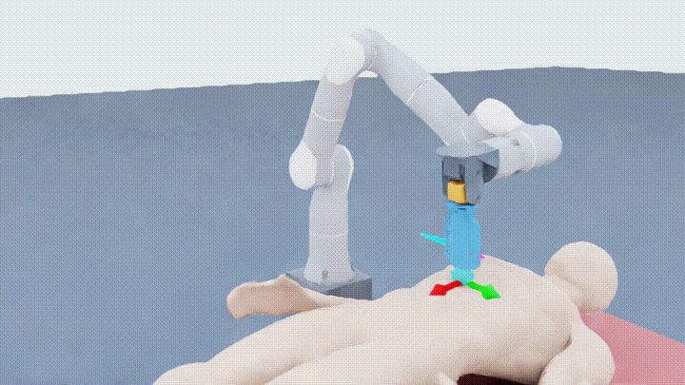
media/results/cardiac-7dof.gif
