RuggedizedWrist/RuggedizedWrist.github.io/media/results/care-coverage.png

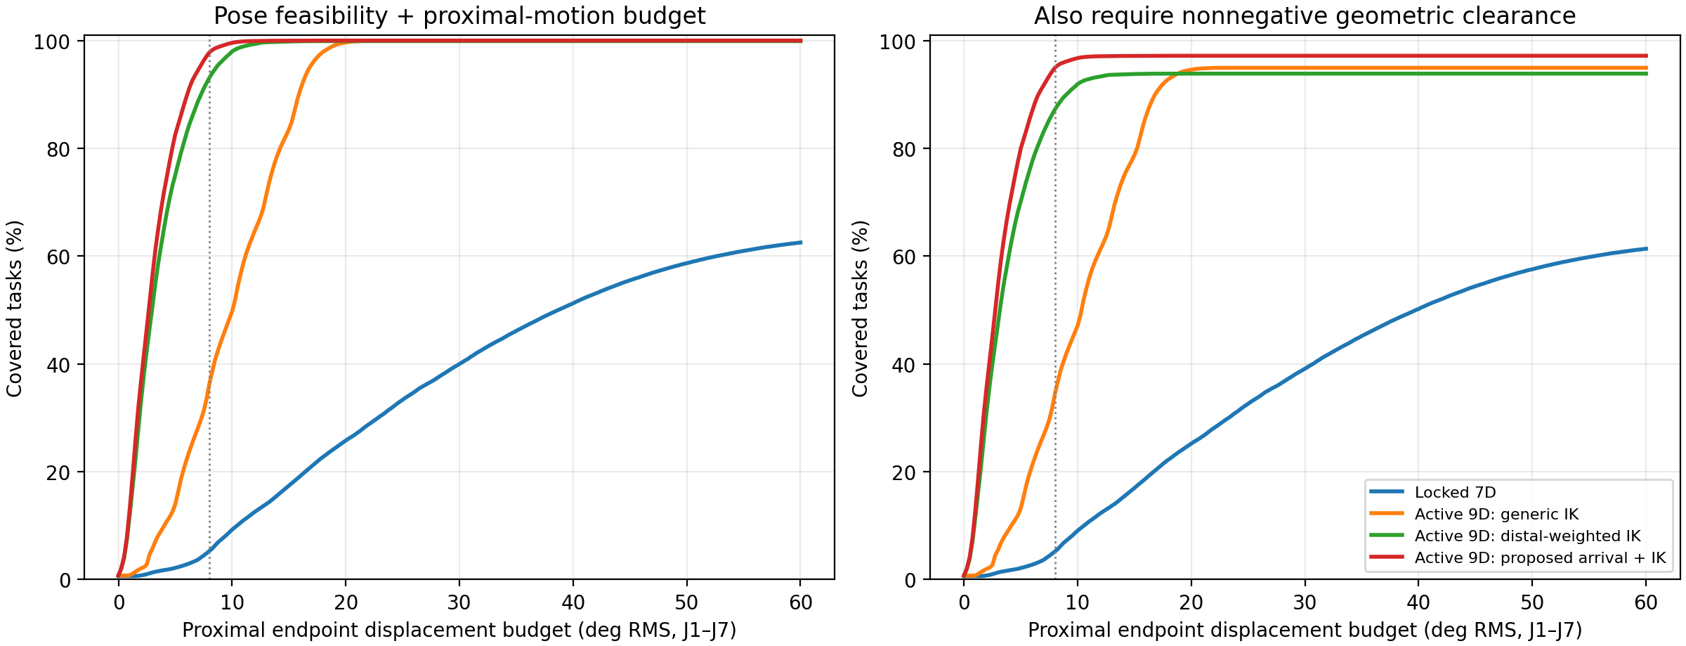
media/results/care-coverage.png
