RuggedizedWrist/RuggedizedWrist.github.io/media/results/care-heatmap.png

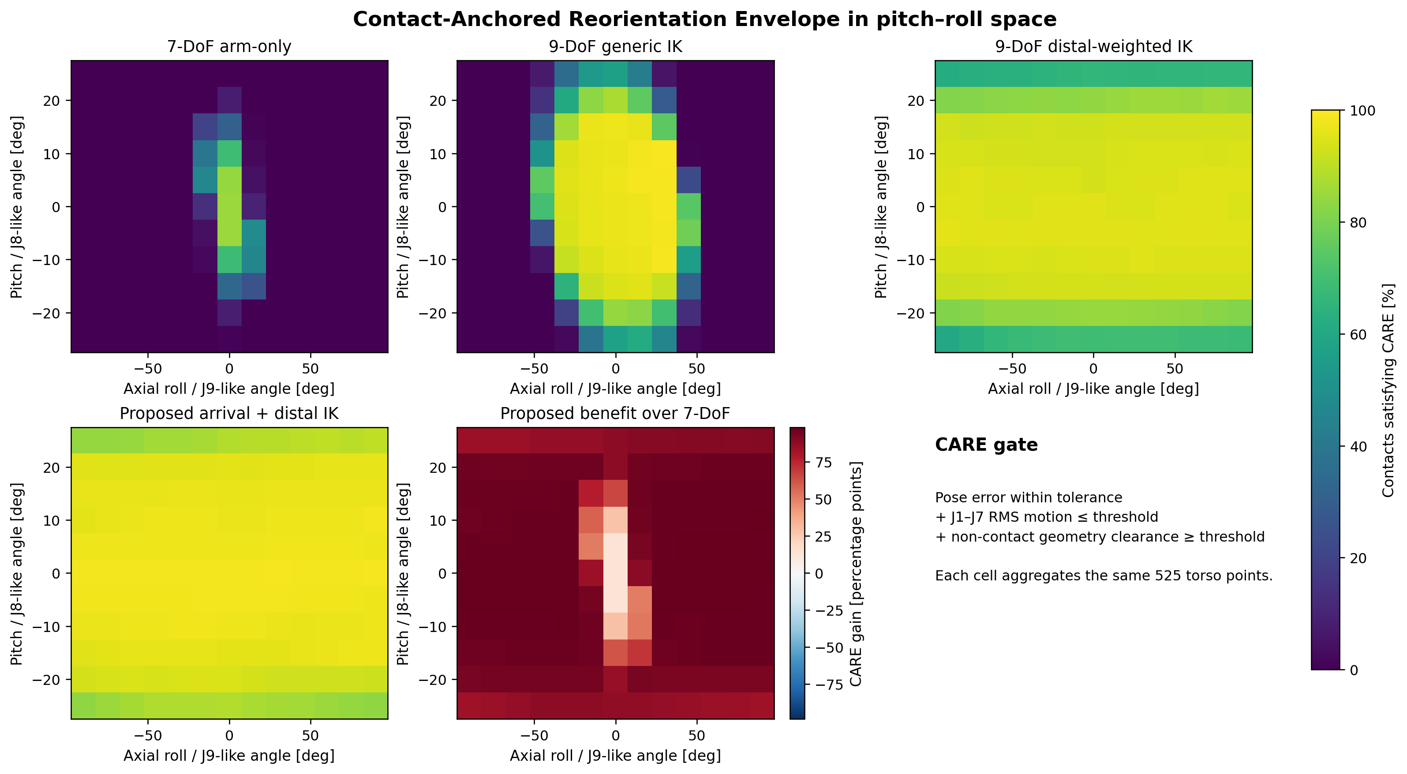
media/results/care-heatmap.png
