RuggedizedWrist/RuggedizedWrist.github.io/media/results/care-methods.png

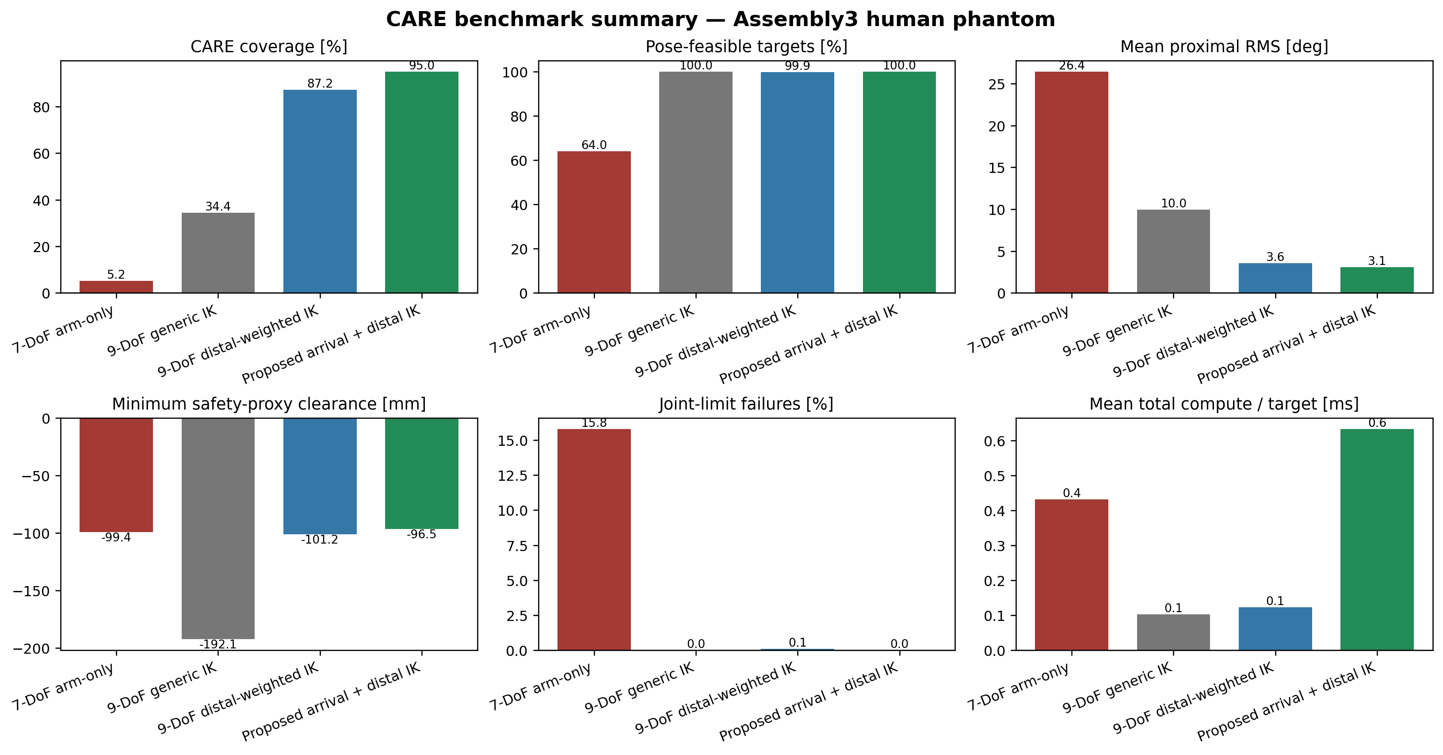
media/results/care-methods.png
