RuggedizedWrist/RuggedizedWrist.github.io/media/results/human-travel.png

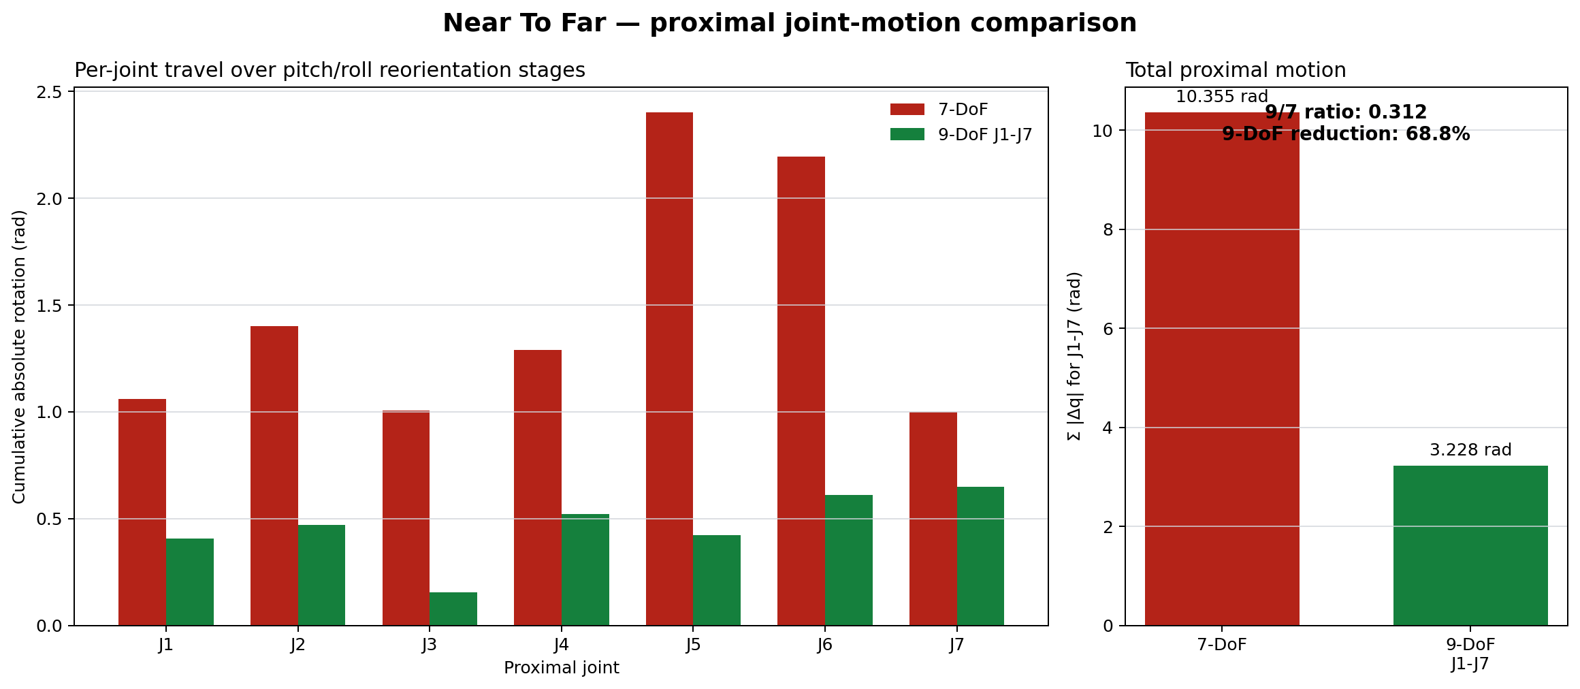
media/results/human-travel.png
