RuggedizedWrist/RuggedizedWrist.github.io/media/results/hydro15-force.png

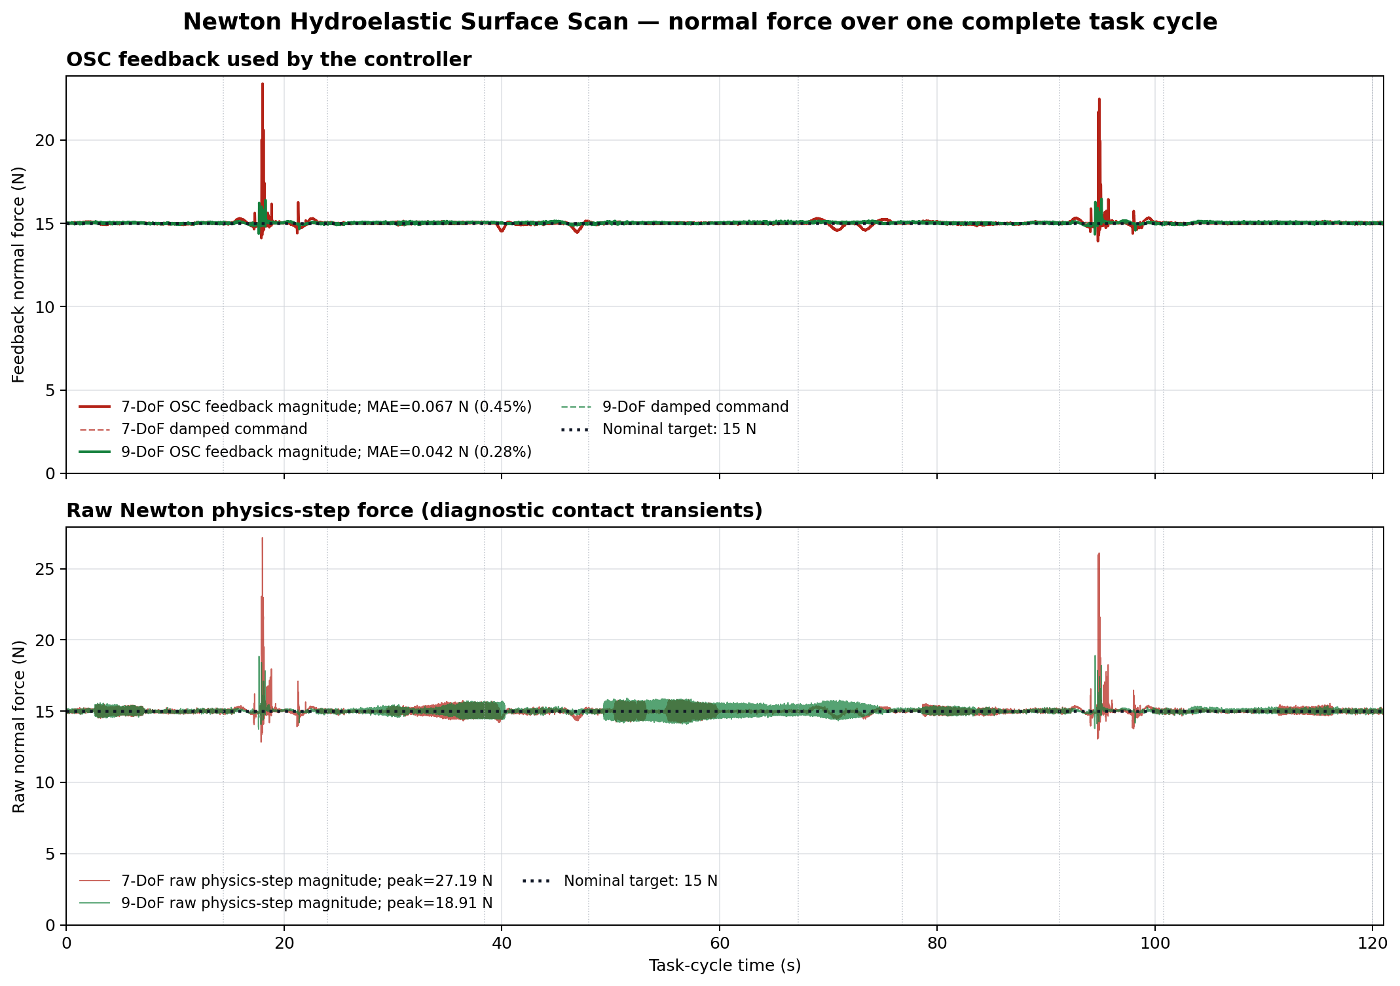
media/results/hydro15-force.png
