RuggedizedWrist/RuggedizedWrist.github.io/media/results/hydro35-force.png

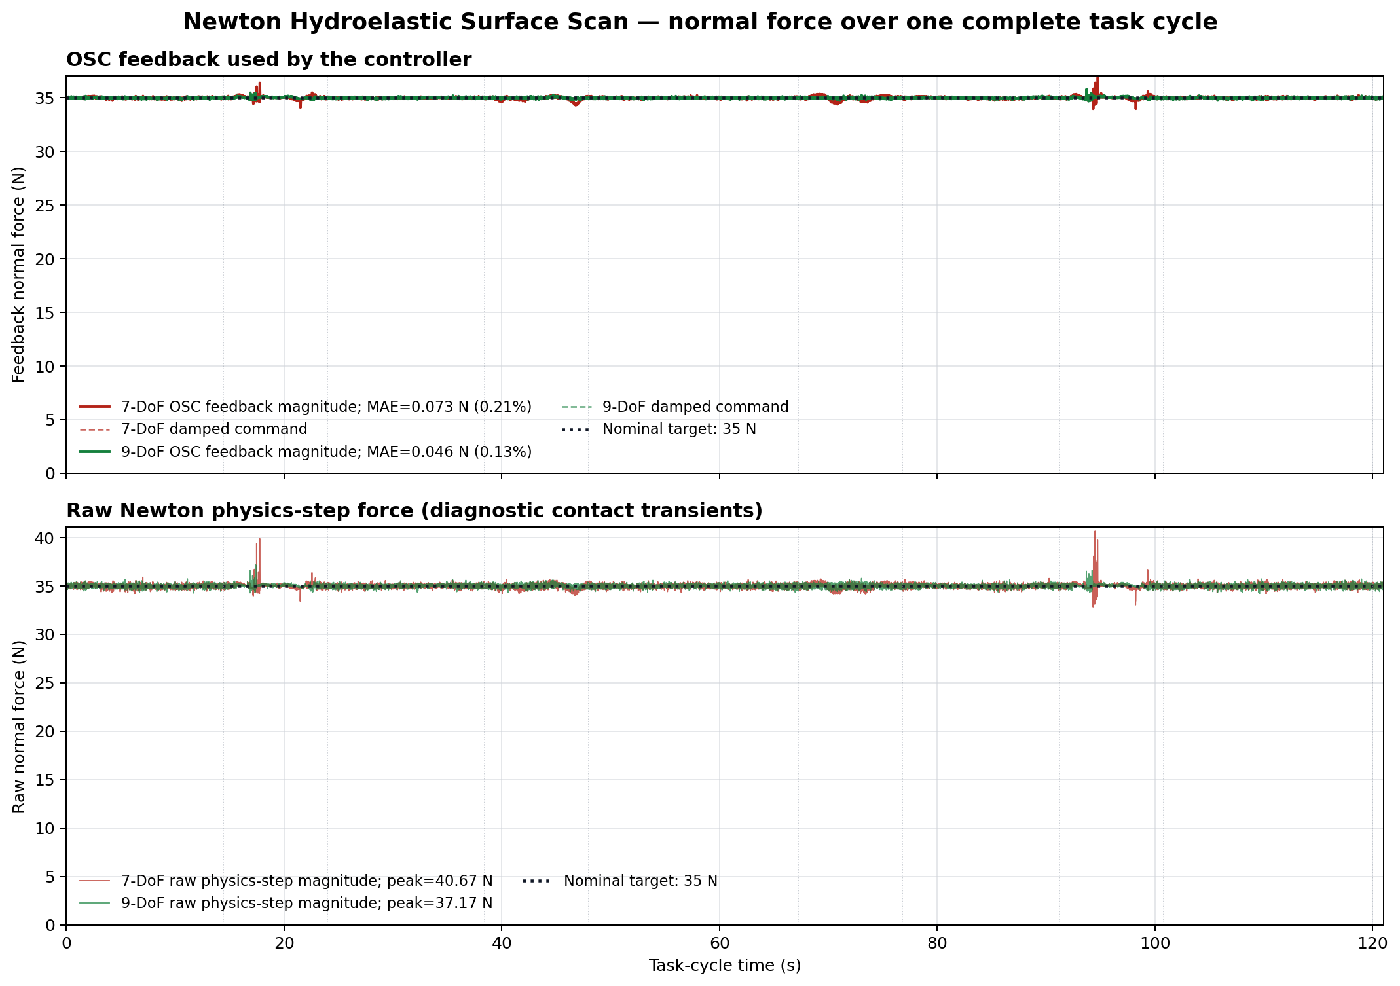
media/results/hydro35-force.png
