RuggedizedWrist/RuggedizedWrist.github.io/media/results/hydro50-force.png

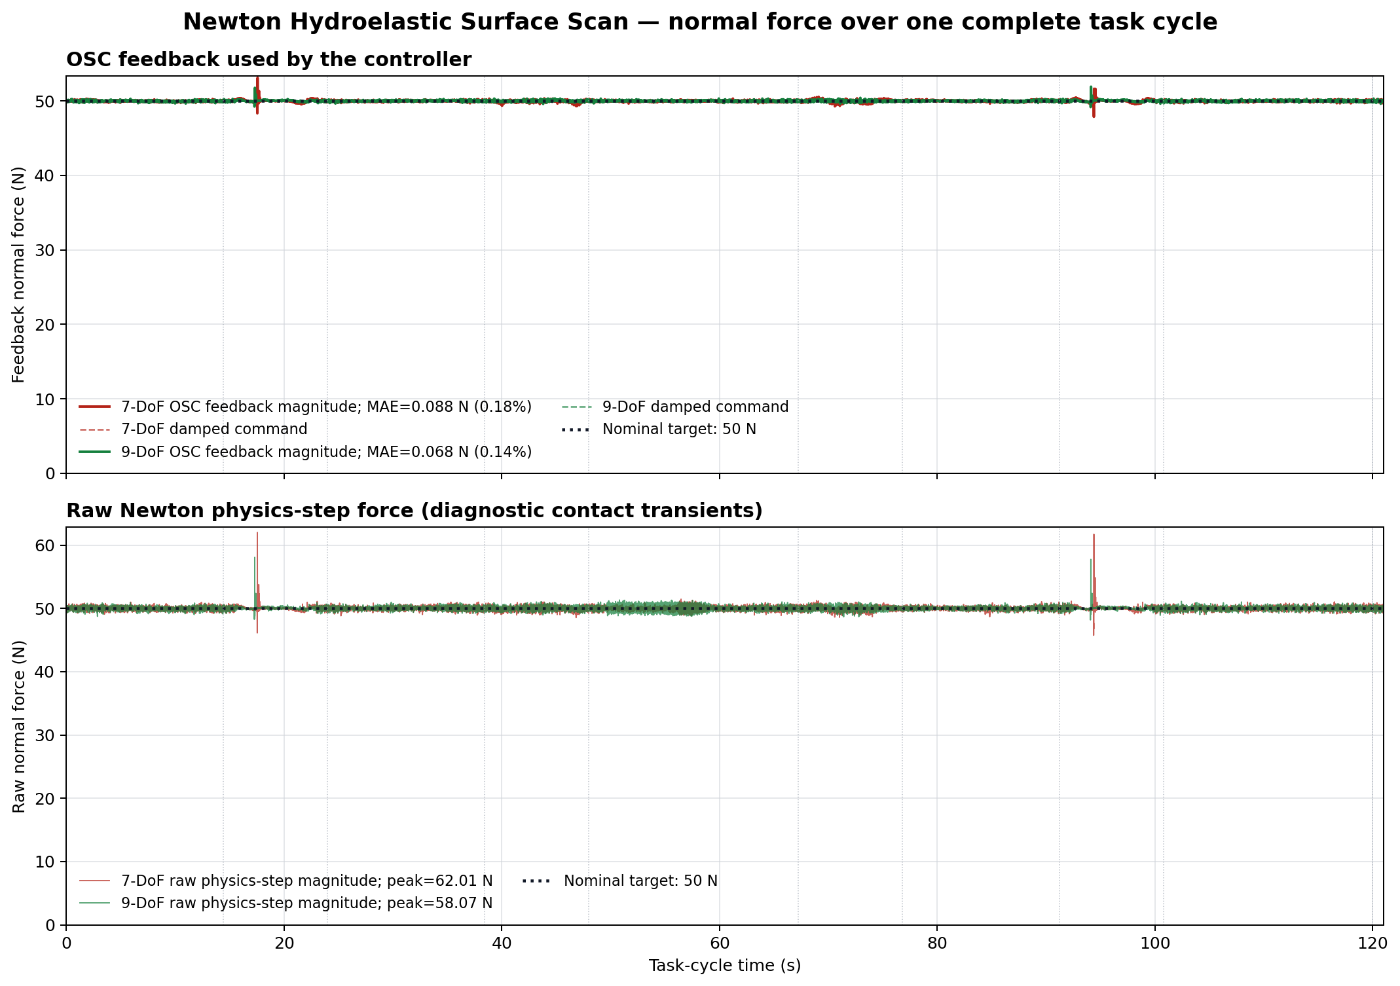
media/results/hydro50-force.png
