RuggedizedWrist/RuggedizedWrist.github.io/media/results/mount-comparison.png

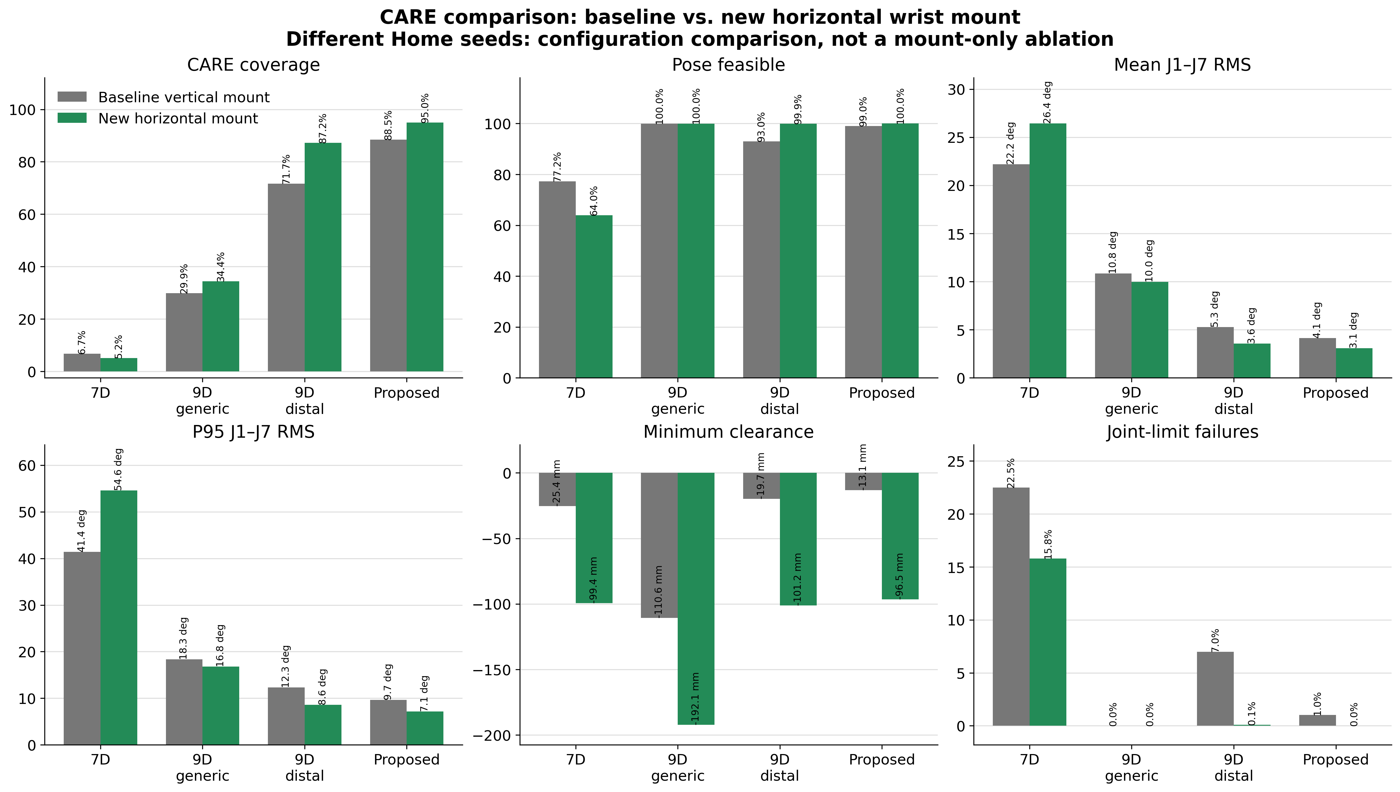
media/results/mount-comparison.png
