RuggedizedWrist/RuggedizedWrist.github.io/media/results/s2-active.png

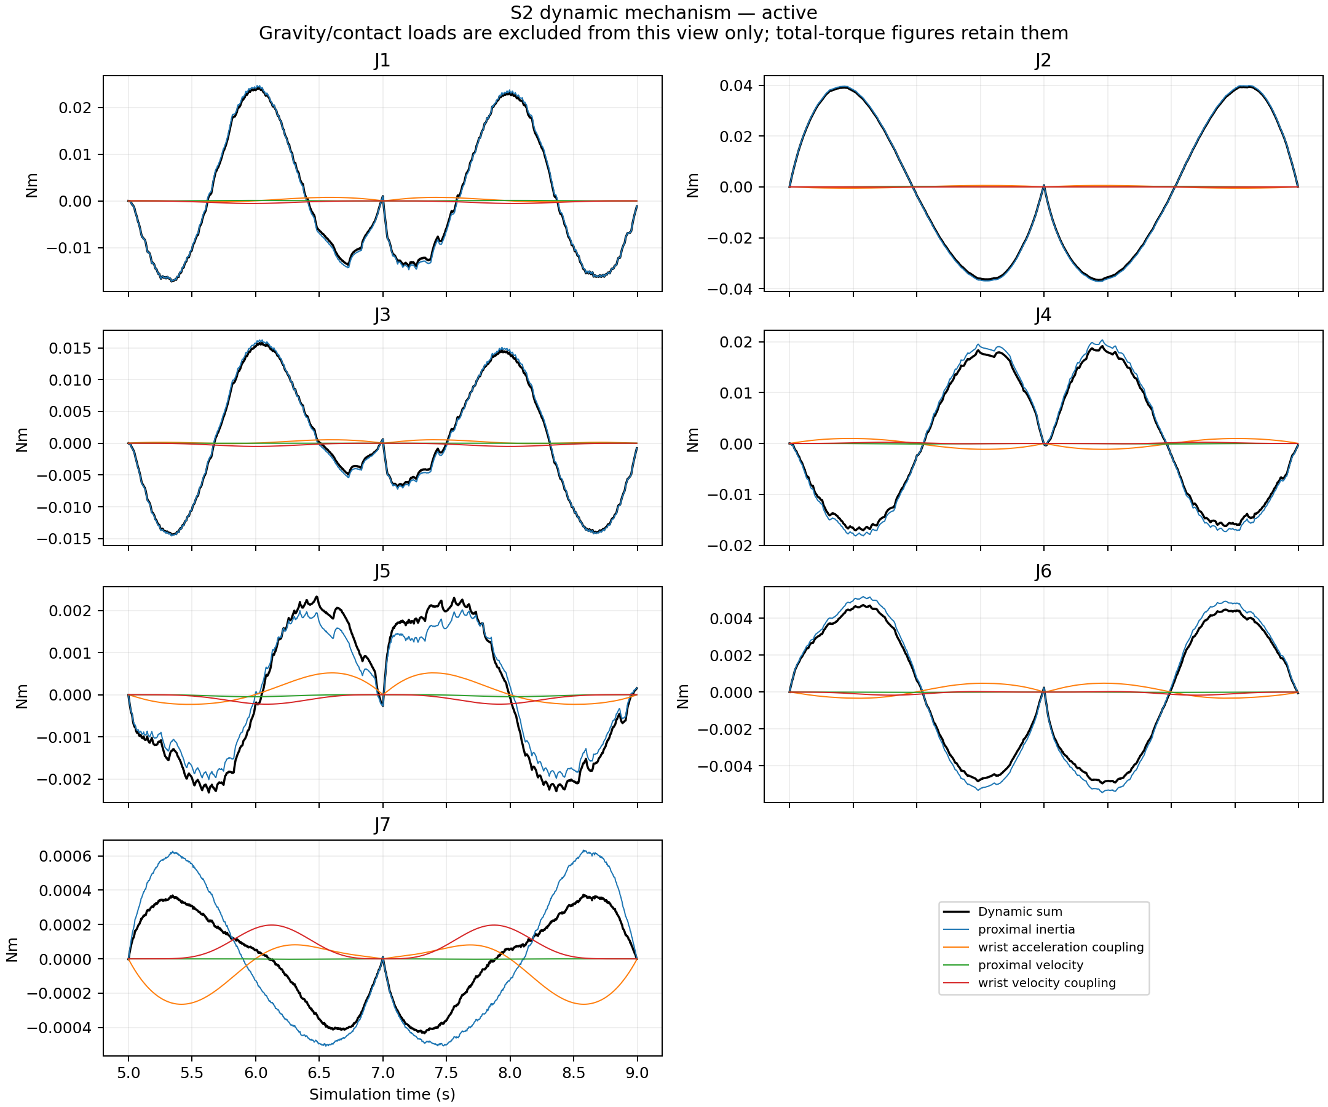
media/results/s2-active.png
