RuggedizedWrist/RuggedizedWrist.github.io/media/results/s2-locked.png

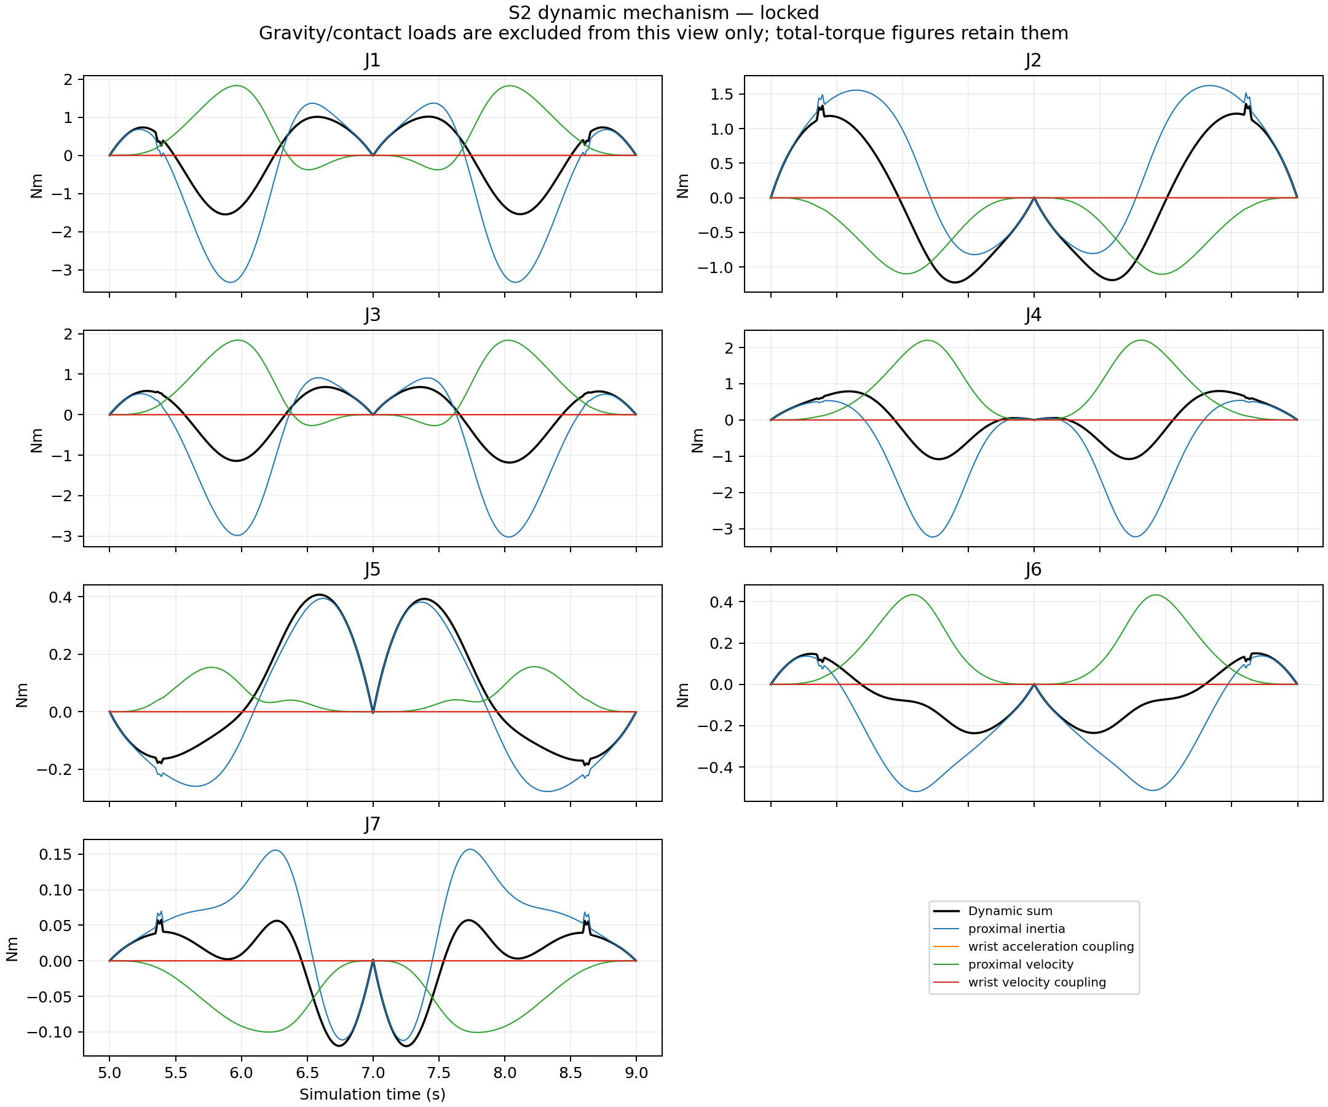
media/results/s2-locked.png
