RuggedizedWrist/RuggedizedWrist.github.io/media/results/s2-total-motor.png

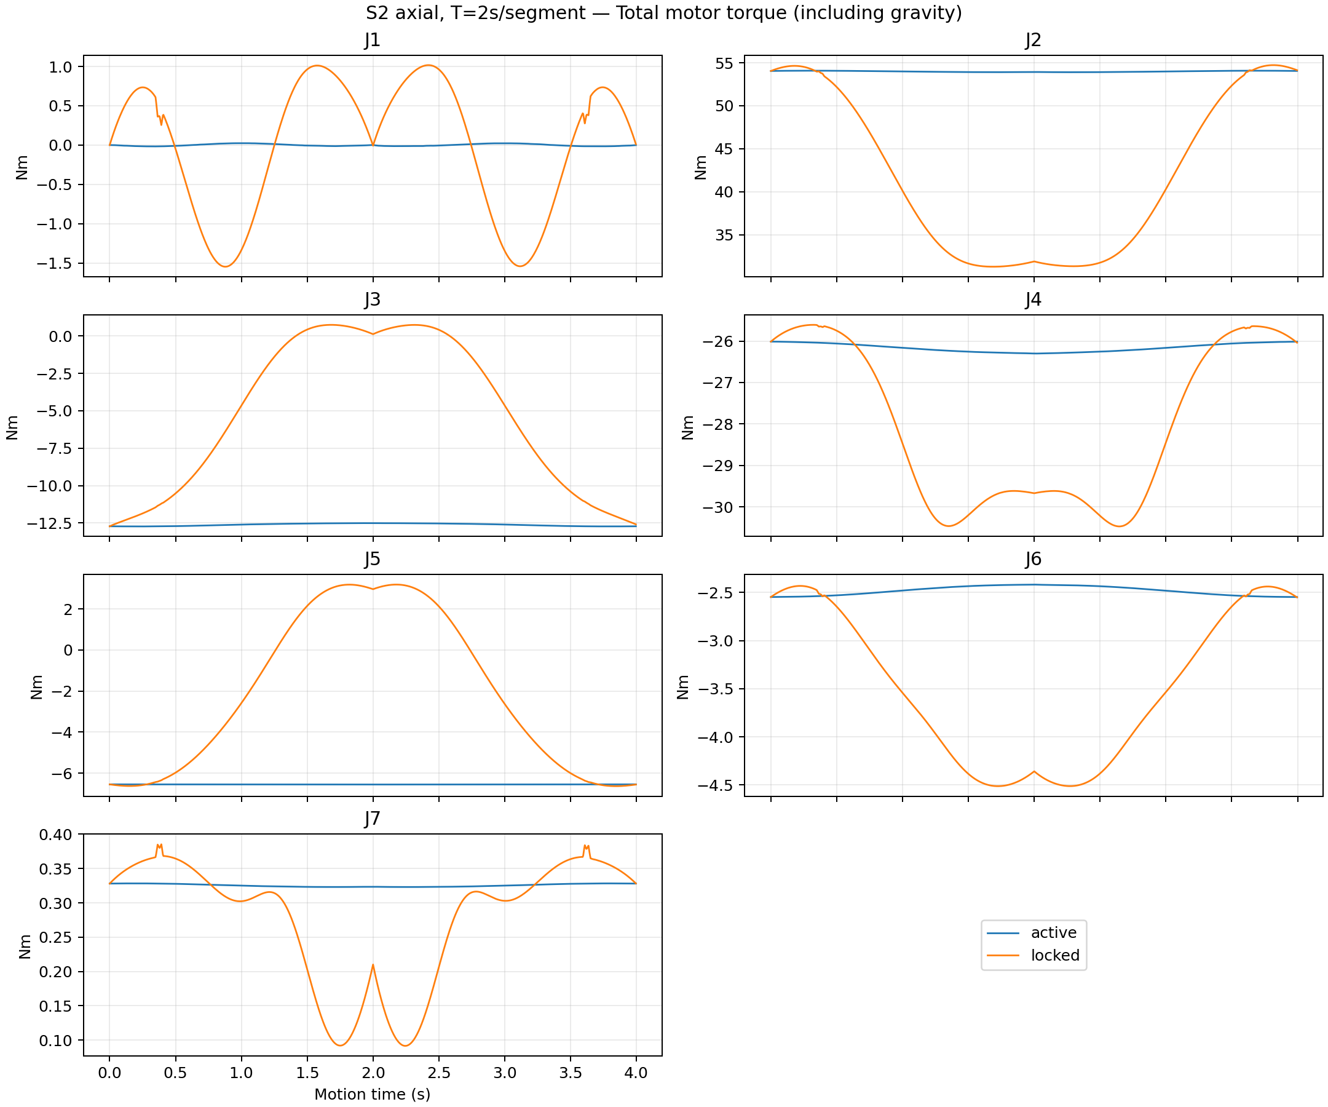
media/results/s2-total-motor.png
