RuggedizedWrist/RuggedizedWrist.github.io/media/results/s3-speed.png

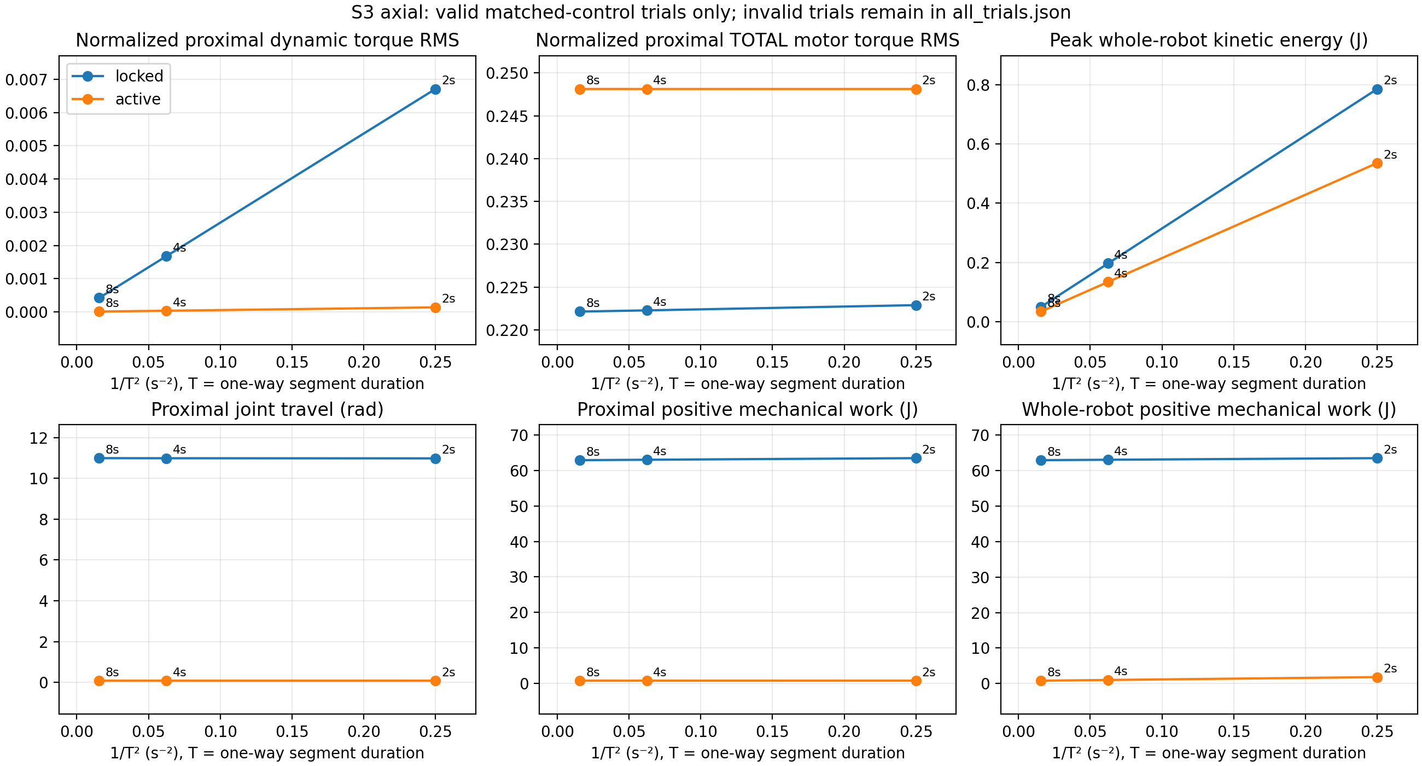
media/results/s3-speed.png
