RuggedizedWrist/RuggedizedWrist.github.io/media/results/swept-volume-all-tasks.png

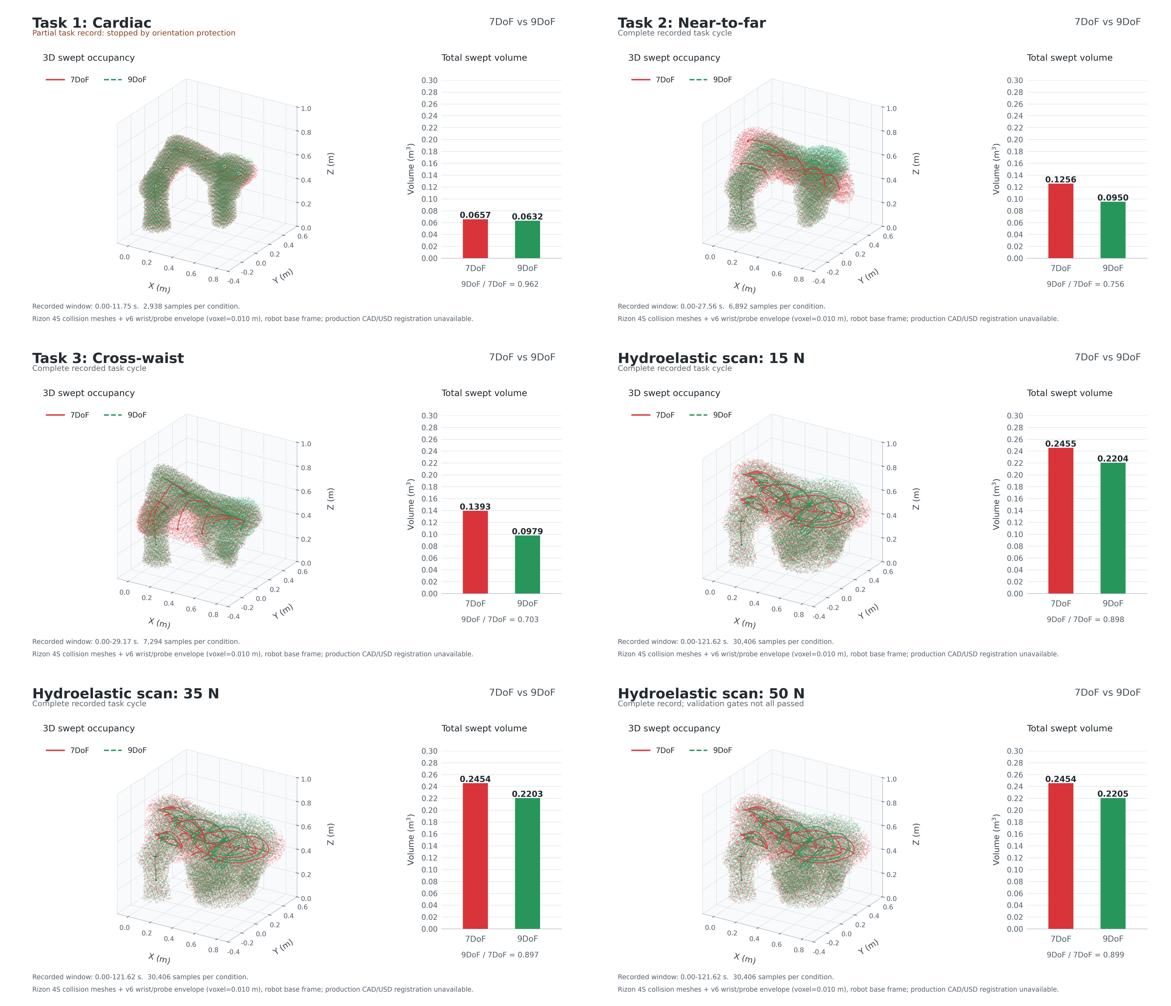
media/results/swept-volume-all-tasks.png
