RuggedizedWrist/RuggedizedWrist.github.io/models/urdf/ruggedized-wrist.urdf

<?xml version='1.0' encoding='utf-8'?>
<robot name="ruggedized_wrist_onshape">
  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
  <link name="root" />
  <link name="wrist_base">
    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
  </link>
  <joint name="root_to_base" type="fixed">
    <parent link="root" />
    <child link="wrist_base" />
    <origin xyz="0 -0.00025 0.04545" />
  </joint>
  <link name="mount_to_arm">
    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
  </link>
  <joint name="base_to_mount" type="fixed">
    <parent link="wrist_base" />
    <child link="mount_to_arm" />
    <origin xyz="0 0.00025 -0.0298" />
  </joint>
  <link name="pitch_motor">
    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
  </link>
  <joint name="base_to_pitch_motor" type="fixed">
    <parent link="wrist_base" />
    <child link="pitch_motor" />
    <origin xyz="0.0223882 0.0334 0.0159693" />
  </joint>
  <link name="pitch_pulley_connector">
    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
  </link>
  <joint name="pitch_drive_fixed" type="fixed">
    <parent link="pitch_motor" />
    <child link="pitch_pulley_connector" />
    <origin xyz="-0.0223882 -0.0471 -0.0159693" />
  </joint>
  <link name="pitch_pulley">
    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
  </link>
  <joint name="connector_to_pulley" type="fixed">
    <parent link="pitch_pulley_connector" />
    <child link="pitch_pulley" />
    <origin xyz="0 -0.0099 0" rpy="0 -0.0947442 0" />
  </joint>
  <link name="roll_motor_bracket">
    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
  </link>
  <joint name="wrist_pitch_joint" type="revolute">
    <parent link="wrist_base" />
    <child link="roll_motor_bracket" />
    <origin xyz="0 0.0324 0.0605" />
    <axis xyz="0 1 0" />
    <limit lower="-1.570796" upper="1.570796" effort="12" velocity="2" />
  </joint>
  <link name="roll_motor_housing">
    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
  </link>
  <joint name="bracket_to_roll_motor" type="fixed">
    <parent link="roll_motor_bracket" />
    <child link="roll_motor_housing" />
    <origin xyz="0.0212802 -0.0176901 -0.0208303" rpy="0 -0.0947442 0" />
  </joint>
  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
  <link name="roll_output">
    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
  </link>
  <joint name="wrist_roll_joint" type="revolute">
    <parent link="roll_motor_housing" />
    <child link="roll_output" />
    <origin xyz="-0.0192142 -0.0139599 0.0323" />
    <axis xyz="0 0 1" />
    <limit lower="-3.141593" upper="3.141593" effort="12" velocity="2" />
  </joint>
  <link name="gecko_attachment">
    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
  </link>
  <joint name="roll_output_to_gecko" type="fixed">
    <parent link="roll_output" />
    <child link="gecko_attachment" />
    <origin xyz="0 0 0.0087" />
  </joint>
</robot>
