RuggedizedWrist/RuggedizedWrist.github.io/assets/urdf-data.js

/* Generated manifest for sandboxed anonymous-review hosting. */
window.__ruggedizedWristUrdfSource = "<?xml version='1.0' encoding='utf-8'?>\n<robot name=\"ruggedized_wrist_onshape\">\n  <!-- Original Onshape STL triangles only: no GLB, merging, decimation, remeshing, probe, or generated primitive geometry. -->\n  <material name=\"imported_motor\">\n    <color rgba=\"0.91 0.91 0.91 1\" />\n  </material>\n  <material name=\"base_finish\">\n    <color rgba=\"0.501961 0.486275 0.439216 1\" />\n  </material>\n  <material name=\"machined_finish\">\n    <color rgba=\"0.901961 0.878431 0.811765 1\" />\n  </material>\n  <material name=\"pulley_finish\">\n    <color rgba=\"0.917647 0.917647 0.917647 1\" />\n  </material>\n  <material name=\"gecko_finish\">\n    <color rgba=\"0.35 0.43 0.31 1\" />\n  </material>\n  <link name=\"root\" />\n  <link name=\"wrist_base\">\n    <visual>\n      <geometry>\n        <mesh filename=\"original-stl-v1/Base.stl\" />\n      </geometry>\n      <material name=\"base_finish\" />\n    </visual>\n  </link>\n  <joint name=\"root_to_base\" type=\"fixed\">\n    <parent link=\"root\" />\n    <child link=\"wrist_base\" />\n    <origin xyz=\"0 -0.00025 0.04545\" />\n  </joint>\n  <link name=\"mount_to_arm\">\n    <visual>\n      <origin xyz=\"0 -0.00025 0.0298\" />\n      <geometry>\n        <mesh filename=\"original-stl-v1/mountToArm.stl\" />\n      </geometry>\n      <material name=\"machined_finish\" />\n    </visual>\n  </link>\n  <joint name=\"base_to_mount\" type=\"fixed\">\n    <parent link=\"wrist_base\" />\n    <child link=\"mount_to_arm\" />\n    <origin xyz=\"0 0.00025 -0.0298\" />\n  </joint>\n  <link name=\"pitch_motor\">\n    <visual>\n      <origin xyz=\"-0.0223882 -0.033 -0.0159693\" />\n      <geometry>\n        <mesh filename=\"original-stl-v1/_3D______5044_5600_6709_2023_10_245047.stl\" />\n      </geometry>\n      <material name=\"imported_motor\" />\n    </visual>\n    <visual>\n      <origin xyz=\"-0.0223882 -0.033 -0.0159693\" />\n      <geometry>\n        <mesh filename=\"original-stl-v1/_3D______5044_5600_6709_2023_10_245047_1.stl\" />\n      </geometry>\n      <material name=\"imported_motor\" />\n    </visual>\n    <visual>\n      <origin xyz=\"-0.0223882 -0.033 -0.0159693\" />\n      <geometry>\n        <mesh filename=\"original-stl-v1/_3D______5044_5600_6709_2023_10_245047_2.stl\" />\n      </geometry>\n      <material name=\"imported_motor\" />\n    </visual>\n    <visual>\n      <origin xyz=\"-0.0223882 -0.033 -0.0159693\" />\n      <geometry>\n        <mesh filename=\"original-stl-v1/_3D______5044_5600_6709_2023_10_245047_3.stl\" />\n      </geometry>\n      <material name=\"imported_motor\" />\n    </visual>\n    <visual>\n      <origin xyz=\"-0.0223882 -0.033 -0.0159693\" />\n      <geometry>\n        <mesh filename=\"original-stl-v1/_3D______5044_5600_6709_2023_10_245047_4.stl\" />\n      </geometry>\n      <material name=\"imported_motor\" />\n    </visual>\n    <visual>\n      <origin xyz=\"-0.0223882 -0.033 -0.0159693\" />\n      <geometry>\n        <mesh filename=\"original-stl-v1/_3D______5044_5600_6709_2023_10_245047_5.stl\" />\n      </geometry>\n      <material name=\"imported_motor\" />\n    </visual>\n    <visual>\n      <origin xyz=\"-0.0223882 -0.033 -0.0159693\" />\n      <geometry>\n        <mesh filename=\"original-stl-v1/_3D______5044_5600_6709_2023_10_245047_6.stl\" />\n      </geometry>\n      <material name=\"imported_motor\" />\n    </visual>\n    <visual>\n      <origin xyz=\"-0.0223882 -0.033 -0.0159693\" />\n      <geometry>\n        <mesh filename=\"original-stl-v1/_3D______5044_5600_6709_2023_10_245047_7.stl\" />\n      </geometry>\n      <material name=\"imported_motor\" />\n    </visual>\n    <visual>\n      <origin xyz=\"-0.0223882 -0.033 -0.0159693\" />\n      <geometry>\n        <mesh filename=\"original-stl-v1/_3D______5044_5600_6709_2023_10_245047_8.stl\" />\n      </geometry>\n      <material name=\"imported_motor\" />\n    </visual>\n    <visual>\n      <origin xyz=\"-0.0223882 -0.033 -0.0159693\" />\n      <geometry>\n        <mesh filename=\"original-stl-v1/_3D______5044_5600_6709_2023_10_245047_9.stl\" />\n      </geometry>\n      <material name=\"imported_motor\" />\n    </visual>\n    <visual>\n      <origin xyz=\"-0.0223882 -0.033 -0.0159693\" />\n      <geometry>\n        <mesh filename=\"original-stl-v1/_3D______5044_5600_6709_2023_10_245047_10.stl\" />\n      </geometry>\n      <material name=\"imported_motor\" />\n    </visual>\n    <visual>\n      <origin xyz=\"-0.0223882 -0.033 -0.015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
_3D______5044_5600_6709_2023_10_245047_220.stl\" />\n      </geometry>\n      <material name=\"imported_motor\" />\n    </visual>\n    <visual>\n      <origin xyz=\"-0.0223882 -0.033 -0.0159693\" />\n      <geometry>\n        <mesh filename=\"original-stl-v1/_3D______5044_5600_6709_2023_10_245047_221.stl\" />\n      </geometry>\n      <material name=\"imported_motor\" />\n    </visual>\n  </link>\n  <joint name=\"base_to_pitch_motor\" type=\"fixed\">\n    <parent link=\"wrist_base\" />\n    <child link=\"pitch_motor\" />\n    <origin xyz=\"0.0223882 0.0334 0.0159693\" />\n  </joint>\n  <link name=\"pitch_pulley_connector\">\n    <visual>\n      <origin xyz=\"0 0.0141 0\" rpy=\"0 -0.0947442 0\" />\n      <geometry>\n        <mesh filename=\"original-stl-v1/PitchMotorPulleyConnector.stl\" />\n      </geometry>\n      <material name=\"machined_finish\" />\n    </visual>\n  </link>\n  <joint name=\"pitch_drive_fixed\" type=\"fixed\">\n    <parent link=\"pitch_motor\" />\n    <child link=\"pitch_pulley_connector\" />\n    <origin xyz=\"-0.0223882 -0.0471 -0.0159693\" />\n  </joint>\n  <link name=\"pitch_pulley\">\n    <visual>\n      <origin xyz=\"0 0.024 0\" />\n      <geometry>\n        <mesh filename=\"original-stl-v1/PitchMotorPulley.stl\" />\n      </geometry>\n      <material name=\"pulley_finish\" />\n    </visual>\n  </link>\n  <joint name=\"connector_to_pulley\" type=\"fixed\">\n    <parent link=\"pitch_pulley_connector\" />\n    <child link=\"pitch_pulley\" />\n    <origin xyz=\"0 -0.0099 0\" rpy=\"0 -0.0947442 0\" />\n  </joint>\n  <link name=\"roll_motor_bracket\">\n    <visual>\n      <origin xyz=\"0.00572345 -0.032 -0.0602287\" rpy=\"0 -0.0947442 0\" />\n      <geometry>\n        <mesh filename=\"original-stl-v1/RollMotorBracket.stl\" />\n      </geometry>\n      <material name=\"machined_finish\" />\n    </visual>\n  </link>\n  <joint name=\"wrist_pitch_joint\" type=\"revolute\">\n    <parent link=\"wrist_base\" />\n    <child link=\"roll_motor_bracket\" />\n    <origin xyz=\"0 0.0324 0.0605\" />\n    <axis xyz=\"0 1 0\" />\n    <limit lower=\"-1.570796\" upper=\"1.570796\" effort=\"12\" velocity=\"2\" />\n  </joint>\n  <link name=\"roll_motor_housing\">\n    <visual>\n      <origin xyz=\"-0.0192142 -0.0143099 -0.03755\" />\n      <geometry>\n        <mesh filename=\"original-stl-v1/_______1.stl\" />\n      </geometry>\n      <material name=\"imported_motor\" />\n    </visual>\n    <visual>\n      <origin xyz=\"-0.0192142 -0.0143099 -0.03755\" />\n      <geometry>\n        <mesh filename=\"original-stl-v1/_2____44380227.stl\" />\n      </geometry>\n      <material name=\"imported_motor\" />\n    </visual>\n    <visual>\n      <origin xyz=\"-0.0192142 -0.0143099 -0.03755\" />\n      <geometry>\n        <mesh filename=\"original-stl-v1/_303740227.stl\" />\n      </geometry>\n      <material name=\"imported_motor\" />\n    </visual>\n    <visual>\n      <origin xyz=\"-0.0192142 -0.0143099 -0.03755\" />\n      <geometry>\n        <mesh filename=\"original-stl-v1/____44380227.stl\" />\n      </geometry>\n      <material name=\"imported_motor\" />\n    </visual>\n    <visual>\n      <origin xyz=\"-0.0192142 -0.0143099 -0.03755\" />\n      <geometry>\n        <mesh filename=\"original-stl-v1/____44380227_1.stl\" />\n      </geometry>\n      <material name=\"imported_motor\" />\n    </visual>\n    <visual>\n      <origin xyz=\"-0.0192142 -0.0143099 -0.03755\" />\n      <geometry>\n        <mesh filename=\"original-stl-v1/______.stl\" />\n      </geometry>\n      <material name=\"imported_motor\" />\n    </visual>\n    <visual>\n      <origin xyz=\"-0.0192142 -0.0143099 -0.03755\" />\n      <geometry>\n        <mesh filename=\"original-stl-v1/______44380227_1.stl\" />\n      </geometry>\n      <material name=\"imported_motor\" />\n    </visual>\n    <visual>\n      <origin xyz=\"-0.0192142 -0.0143099 -0.03755\" />\n      <geometry>\n        <mesh filename=\"original-stl-v1/__________4438.stl\" />\n      </geometry>\n      <material name=\"imported_motor\" />\n    </visual>\n  </link>\n  <joint name=\"bracket_to_roll_motor\" type=\"fixed\">\n    <parent link=\"roll_motor_bracket\" />\n    <child link=\"roll_motor_housing\" />\n    <origin xyz=\"0.0212802 -0.0176901 -0.0208303\" rpy=\"0 -0.0947442 0\" />\n  </joint>\n  <!-- J9 rotates only the original central cylindrical output STL. -->\n  <link name=\"roll_output\">\n    <visual>\n      <origin xyz=\"0 -0.00035 -0.06985\" />\n      <geometry>\n        <mesh filename=\"original-stl-v1/______44380227.stl\" />\n      </geometry>\n      <material name=\"imported_motor\" />\n    </visual>\n  </link>\n  <joint name=\"wrist_roll_joint\" type=\"revolute\">\n    <parent link=\"roll_motor_housing\" />\n    <child link=\"roll_output\" />\n    <origin xyz=\"-0.0192142 -0.0139599 0.0323\" />\n    <axis xyz=\"0 0 1\" />\n    <limit lower=\"-3.141593\" upper=\"3.141593\" effort=\"12\" velocity=\"2\" />\n  </joint>\n  <link name=\"gecko_attachment\">\n    <visual>\n      <origin xyz=\"-0.010232 0.000357 0\" />\n      <geometry>\n        <mesh filename=\"original-stl-v1/gecko-original.stl\" scale=\"0.00045 0.00045 0.00045\" />\n      </geometry>\n      <material name=\"gecko_finish\" />\n    </visual>\n  </link>\n  <joint name=\"roll_output_to_gecko\" type=\"fixed\">\n    <parent link=\"roll_output\" />\n    <child link=\"gecko_attachment\" />\n    <origin xyz=\"0 0 0.0087\" />\n  </joint>\n</robot>";
window.__ruggedizedWristMeshSources = {};
