RuggedizedWrist/RuggedizedWrist.github.io/(commit log)

2026-09-11 Prepare anonymous ICRA artifact site
    [Base.stl, KAA15CL0a5047.stl, PitchMotorPulley.stl, PitchMotorPulleyConnector.stl, RollMotorBracket.stl, _2____44380227.stl, _303740227.stl, _3D______5044_5600_6709_2023_10_245047.stl]
2026-09-11 Add total motor torque evidence panel
2026-09-11 Use corrected-mount videos and inline methods
2026-09-11 Fix demo loops and interactive URDF loading
    [ruggedized-wrist-web.urdf]
2026-09-11 Restore original URDF viewer
    [empty.stl, gecko_attachment.stl, mount_to_arm.stl, pitch_pulley.stl, pitch_pulley_connector.stl, roll_motor_bracket.stl, roll_motor_housing.stl, roll_output.stl]
2026-09-16 Anonymize review site assets and links
    [roll_motor_bracket_anonymous.stl]
2026-09-16 Remove all source and CAD navigation links
2026-09-16 Fix detailed URDF loading on review site
    [urdf-data.js]
2026-09-16 Split URDF assets for anonymous mirror
2026-10-05 Restore the draggable URDF viewer and make the figures readable.
    Chart panels now sit on a light field, with SVG versions where they stay sharp, so black labels remain visible on the dark page.
